ikoerber/roadtest/kicad/roadtest_ref/roadtest.kicad_sch

## KiCad design kicad/roadtest_ref/roadtest.kicad_sch (2026-08-06)

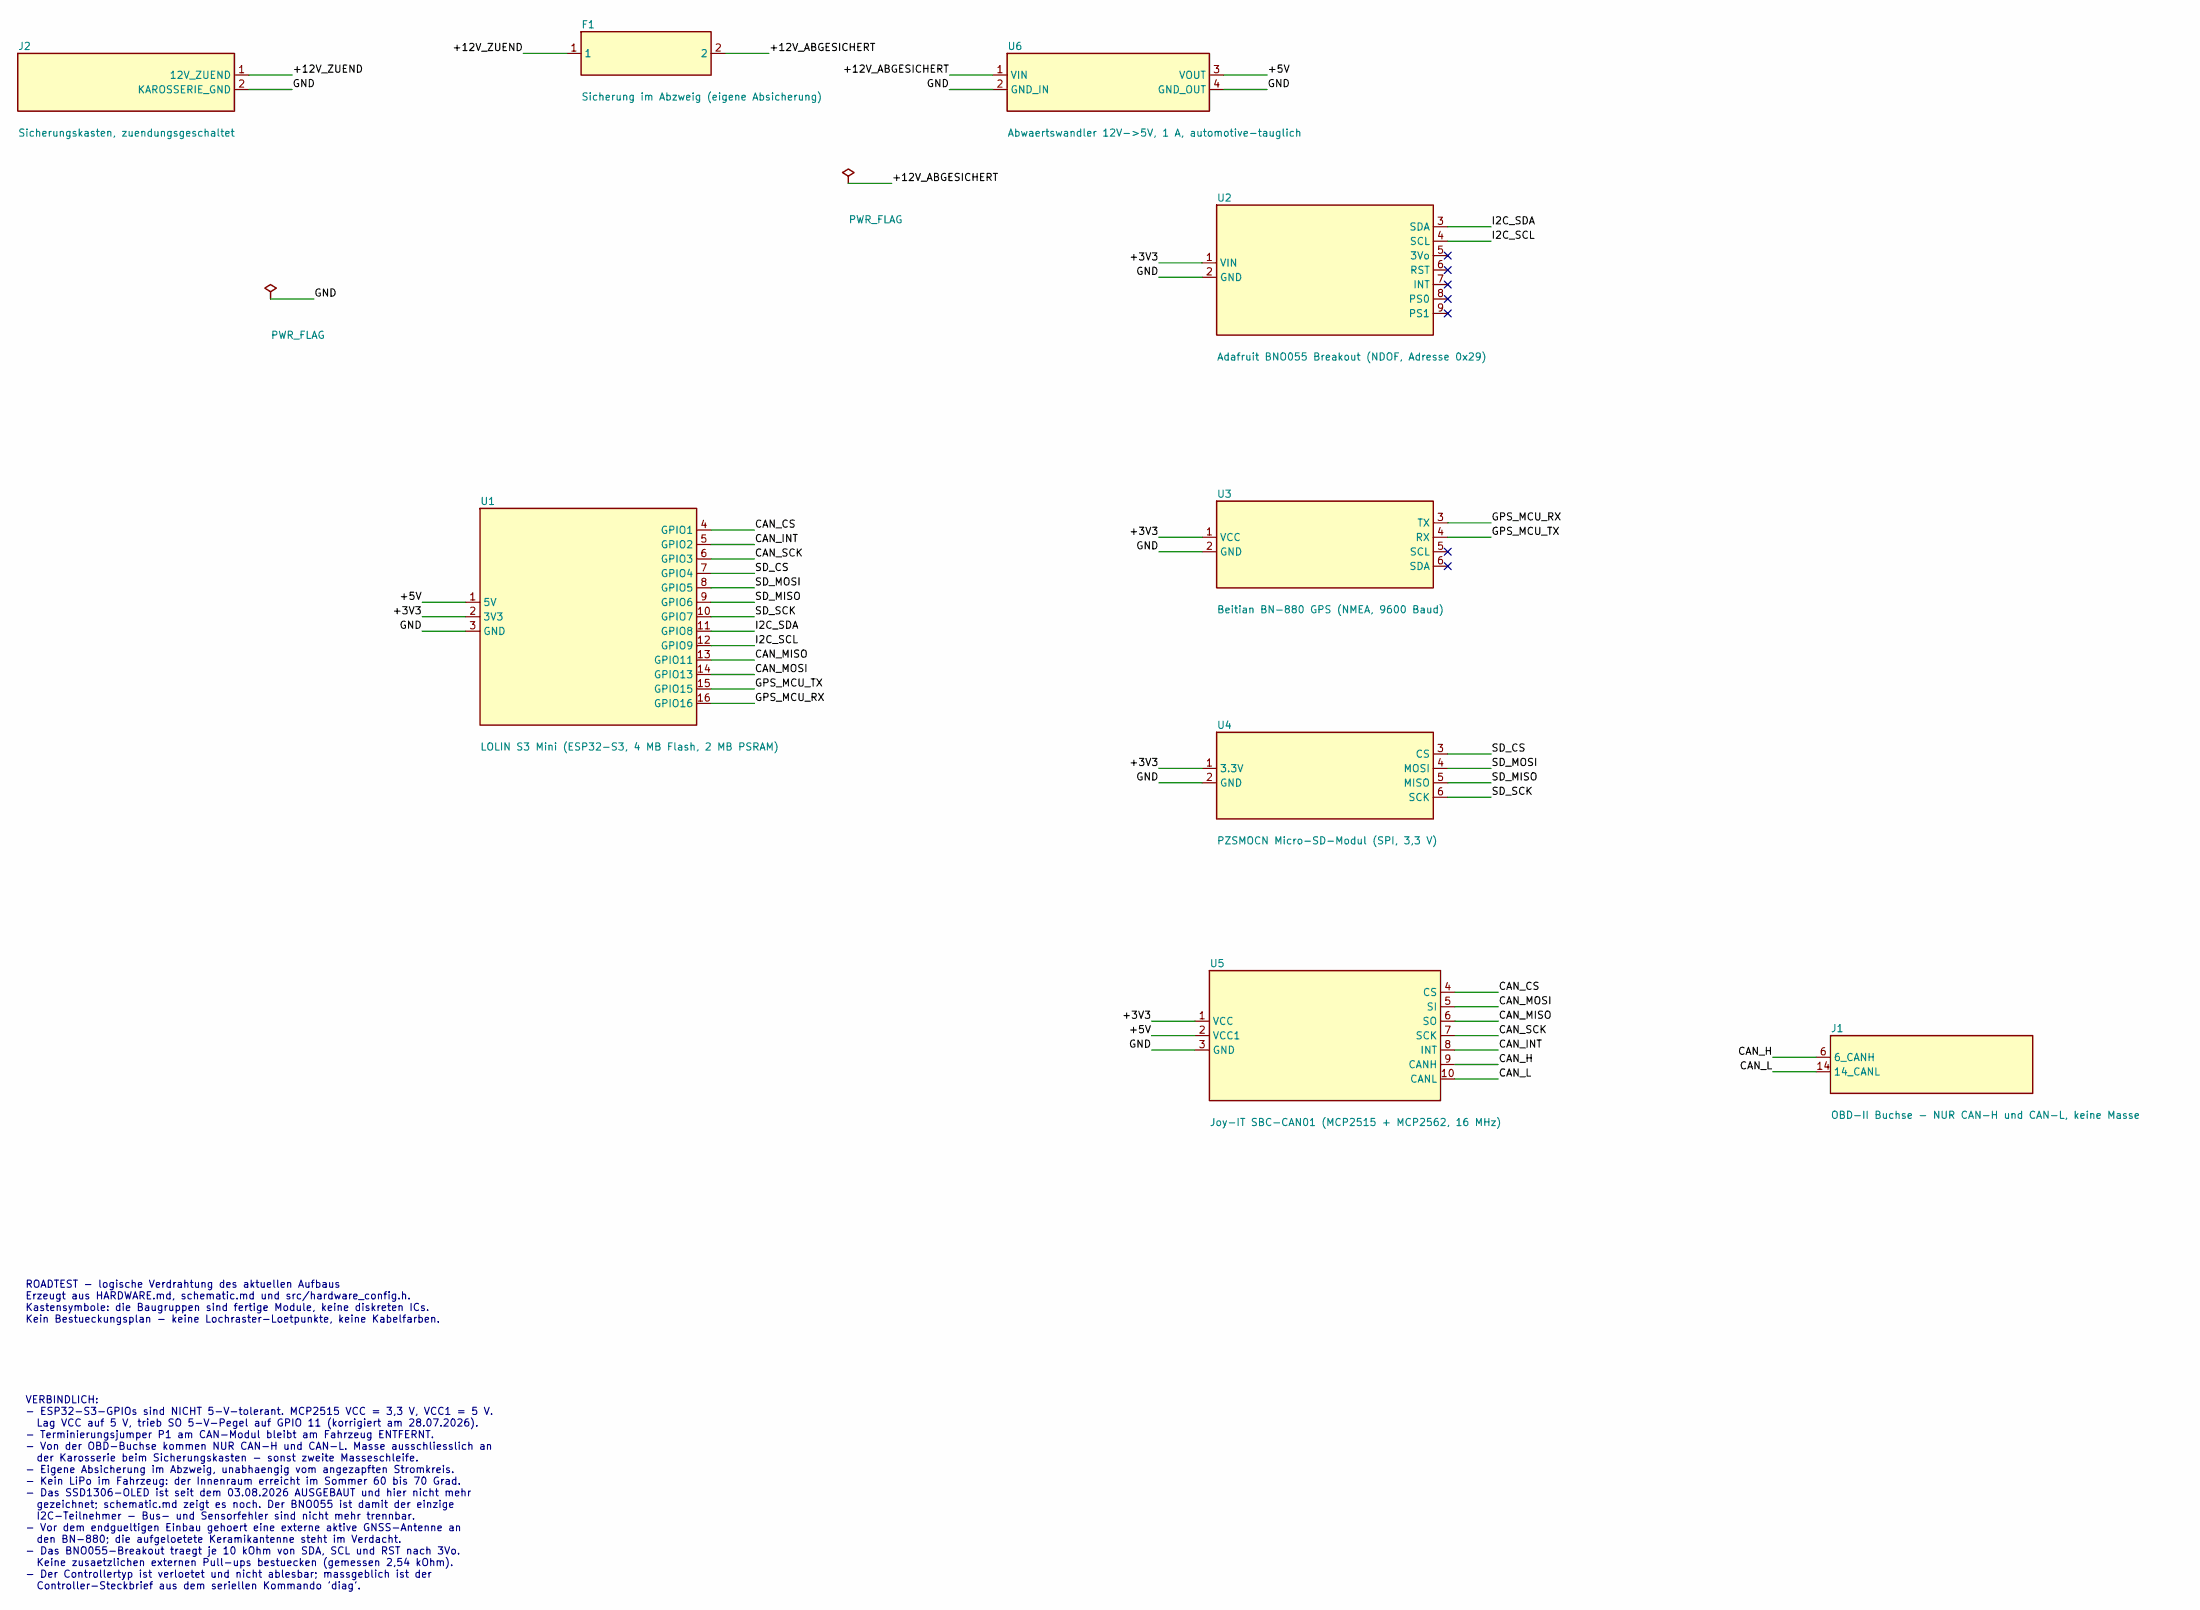
[picture p1: schematic roadtest.kicad_sch]

Parts:
F1: Sicherung im Abzweig (eigene Absicherung)
J1: OBD-II Buchse - NUR CAN-H und CAN-L, keine Masse
J2: Sicherungskasten, zuendungsgeschaltet
U1: LOLIN S3 Mini (ESP32-S3, 4 MB Flash, 2 MB PSRAM)
U2: Adafruit BNO055 Breakout (NDOF, Adresse 0x29)
U3: Beitian BN-880 GPS (NMEA, 9600 Baud)
U4: PZSMOCN Micro-SD-Modul (SPI, 3,3 V)
U5: Joy-IT SBC-CAN01 (MCP2515 + MCP2562, 16 MHz)
U6: Abwaertswandler 12V->5V, 1 A, automotive-tauglich

Connections:
+3V3: U1.2 (3V3), U2.1 (VIN), U3.1 (VCC), U4.1 (3.3V), U5.1 (VCC)
+5V: U1.1 (5V), U5.2 (VCC1), U6.3 (VOUT)
+12V_ABGESICHERT: F1.2, U6.1 (VIN)
+12V_ZUEND: F1.1, J2.1 (12V_ZUEND)
CAN_CS: U1.4 (GPIO1), U5.4 (CS)
CAN_H: J1.6 (6_CANH), U5.9 (CANH)
CAN_INT: U1.5 (GPIO2), U5.8 (INT)
CAN_L: J1.14 (14_CANL), U5.10 (CANL)
CAN_MISO: U1.13 (GPIO11), U5.6 (SO)
CAN_MOSI: U1.14 (GPIO13), U5.5 (SI)
CAN_SCK: U1.6 (GPIO3), U5.7 (SCK)
GND: J2.2 (KAROSSERIE_GND), U1.3 (GND), U2.2 (GND), U3.2 (GND), U4.2 (GND), U5.3 (GND), U6.2 (GND_IN), U6.4 (GND_OUT)
GPS_MCU_RX: U1.16 (GPIO16), U3.3 (TX)
GPS_MCU_TX: U1.15 (GPIO15), U3.4 (RX)
I2C_SCL: U1.12 (GPIO9), U2.4 (SCL)
I2C_SDA: U1.11 (GPIO8), U2.3 (SDA)
SD_CS: U1.7 (GPIO4), U4.3 (CS)
SD_MISO: U1.9 (GPIO6), U4.5 (MISO)
SD_MOSI: U1.8 (GPIO5), U4.4 (MOSI)
SD_SCK: U1.10 (GPIO7), U4.6 (SCK)

Notes on the sheet:
ROADTEST - logische Verdrahtung des aktuellen Aufbaus Erzeugt aus HARDWARE.md, schematic.md und src/hardware_config.h. Kastensymbole: die Baugruppen sind fertige Module, keine diskreten ICs. Kein Bestueckungsplan - keine Lochraster-Loetpunkte, keine Kabelfarben.
VERBINDLICH: - ESP32-S3-GPIOs sind NICHT 5-V-tolerant. MCP2515 VCC = 3,3 V, VCC1 = 5 V. Lag VCC auf 5 V, trieb SO 5-V-Pegel auf GPIO 11 (korrigiert am 28.07.2026). - Terminierungsjumper P1 am CAN-Modul bleibt am Fahrzeug ENTFERNT. - Von der OBD-Buchse kommen NUR CAN-H und CAN-L. Masse ausschliessli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
