ikoerber/roadtest/src/can_reader.cpp

#include "can_reader.h"
#include "hardware_config.h"
#include <SPI.h>

// Include arduino-CAN Library - Wir nutzen MCP2515 auf ESP32
#undef ARDUINO_ARCH_ESP32  // ESP32-internen CAN deaktivieren
#include "CANController.h"
#include "MCP2515.h"

// Globale CAN-Reader Instanz
CANReader canReader;

// MCP2515 Instanz erstellen
MCP2515Class canController;

static_assert(CAN_OBD_REQUEST_INTERVAL_MS >= 500,
              "OBD-Abfragen duerfen insgesamt hoechstens mit 2 Hz laufen");
static_assert(CAN_OBD_RESPONSE_TIMEOUT_MS < CAN_OBD_REQUEST_INTERVAL_MS,
              "OBD-Timeout muss vor der naechsten Anfrage ablaufen");
static_assert(CAN_OBD_VALUE_MAX_AGE_MS >= CAN_OBD_REQUEST_INTERVAL_MS * 3,
              "OBD-Livewerte muessen mindestens einen vollen PID-Zyklus gelten");
static_assert(!CAN_OBD_POLLING_ENABLED || !CAN_LISTEN_ONLY,
              "Aktive OBD-Abfragen sind im Listen-Only-Modus nicht moeglich");

namespace {
// Die Temperatur-PIDs 0x46 und 0x5C rechnen A - 40 über ein einzelnes Byte.
// 0xFF ist dabei die uebliche Kennung "Wert derzeit nicht verfuegbar" und
// ergaebe umgerechnet 215 °C - fuer Aussenluft physikalisch unmoeglich.
//
// Beleg: In den sieben Discovery-Sitzungen vom 29./30.07.2026 trugen 28 von
// rund 530 Antworten auf 0x46 genau dieses Byte. Die Firmware verbuchte sie
// bis 1.5.36 als gueltige Messwerte, in 20260729_170946_05A4DB46 waren das
// 45 von 2438 als gueltig markierten Zeilen. Ein Mittelwert ueber die
// Aussentemperatur lag dadurch mehrere Grad zu hoch.
//
// Die Grenze gilt nur fuer diese beiden PIDs. Bei Geschwindigkeit (0x0D) und
// Drosselstellung (0x11) ist 0xFF ein regulaerer Wert und darf nicht
// verworfen werden.
constexpr uint8_t OBD_TEMPERATURE_UNAVAILABLE = 0xFF;
}  // namespace

CANReader::CANReader(int cs, int interrupt)
    : initialized(false), messageCount(0),
      csPin(cs), intPin(interrupt),
      clockFrequency(CAN_CLOCK_16MHZ),
      totalMessages(0), errorCount(0),
      receiveBuffer0OverflowCount(0),
      receiveBuffer1OverflowCount(0),
      controllerRecoveryCount(0),
      lastMessage{}, pendingMessage{}, hasPendingMessage(false), obdData{},
      obdPollingEnabled(CAN_OBD_POLLING_ENABLED), obdSession{},
      obdRequestPending(false), pendingOBDHadResponse(false),
      pendingOBDSequence(0),
      pendingOBDRequestMs(0), pendingOBDPid(0), obdTraceQueue{},
      obdTraceReadIndex(0), obdTraceWriteIndex(0) {
}

CANReader::~CANReader() {
    end();
}

bool CANReader::begin(long baudRate) {
    if (initialized) {
        Serial.println("CAN-Reader bereits initialisiert");
        return true;
    }
    
    Serial.println("=== CAN-Bus Reader Initialisierung ===");
    Serial.printf("Pins: CS=%d, INT=%d, SCK=%d, MOSI=%d, MISO=%d\n",
                  csPin, intPin, CAN_SCK_PIN, CAN_MOSI_PIN, CAN_MISO_PIN);

    // Der SPI-Bus wird vom Aufrufer einmalig eingerichtet, siehe
    // initializeOptionalCAN() in main.cpp.
    //
    // Frühere Fassungen riefen hier erneut SPI.end() und SPI.begin() auf, mit
    // dem Kommentar, damit werde "eventuelle SD-SPI Nutzung" beendet. Das war
    // sachlich falsch: Die SD-Karte hängt an der eigenen HSPI-Instanz, CAN am
    // globalen SPI-Objekt. Es sind getrennte Peripherien. Ein Busneustart zur
    // Laufzeit bringt hier nichts und kann eine laufende Übertragung abreißen.
    //
    // Ebenfalls entfernt: die Toggle-Tests, die SCK und MOSI per pinMode() und
    // digitalWrite() ansteuerten, nachdem SPI.begin() dieselben Pins bereits
    // über die GPIO-Matrix der SPI-Einheit zugewiesen hatte. Beide Treiber
    // arbeiteten dabei gegeneinander.
    pinMode(intPin, INPUT_PULLUP);
    pinMode(csPin, OUTPUT);
    digitalWrite(csPin, HIGH);

    canController.setPins(csPin, intPin);

    // MCP2515 mit der fest hinterlegten Quarzfrequenz konfigurieren.
    // Der verbaute Joy-IT SBC-CAN01 trägt einen Quarz mit Aufdruck 16.000.
    // Früher wurde hier 16 MHz probiert und bei Misserfolg auf 8 MHz
    // umgeschaltet. Das ist gefährlich: Eine falsche Annahme wird von
    // begin() nicht erkannt, sondern ergibt eine um Faktor zwei falsche
    // Bitrate. Der Knoten quittiert dann jeden Frame als Fehler, geht in
    // Bus-Off und hält die INT-Leitung dauerhaft aktiv.
    Serial.printf("MCP2515: Quarz %ld Hz, Bitrate %ld bps\n",
                  clockFrequency, baudRate);
    canController.setClockFrequency(clockFrequency);
    canController.setSPIFrequency(1E6); // Niedrige SPI-Geschwindigkeit
    canController.setListenOnly(CAN_LISTEN_ONLY);
    canController.setTransmitTimeout(CAN_TX_TIMEOUT_MS);
    Serial.printf("MCP2515-Modus: %s\n",
                  CAN_OBD_POLLING_ENABLED
                      ? "OBD-Abfrage (aktiv, nur lesend)"
                      : (CAN_LISTEN_ONLY ? "Listen-Only (passiv)" : "Normal"));

    if (!canController.begin(baudRate)) {
        Serial.println("❌ CAN-Bus Initialisierung fehlgeschlagen!");
        Serial.println("Mögliche Ursachen:");
        Serial.printf("• Verkabelung: CS=GPIO%d, INT=GPIO%d, SCK=GPIO%d, MOSI=GPIO%d, MISO=GPIO%d\n",
                      csPin, intPin, CAN_SCK_PIN, CAN_MOSI_PIN, CAN_MISO_PIN);
        Serial.println("• Stromversorgung: VCC=3,3V (Logik), VCC1=5V (Bustreiber)");
        Serial.println("• Quarzaufdruck gegen CAN_CLOCK_16MHZ in hardware_config.h prüfen");
        Serial.println("• MCP2515 defekt oder nicht verbunden");
        errorCount++;
        return false;
    }

    // Im aktiven OBD-Modus nur die acht standardisierten physischen
    // Antwort-IDs in die beiden MCP2515-Empfangspuffer lassen. So verdrängt
    // normaler Fahrzeugverkehr keine angeforderte OBD-Antwort.
    if (CAN_OBD_POLLING_ENABLED &&
        !canController.filter(0x7E8, 0x7F8)) {
        Serial.println("❌ OBD-Antwortfilter konnte nicht gesetzt werden");
        canController.end();
        errorCount++;
        return false;
    }
    
    initialized = true;
    hasPendingMessage = false;
    pendingMessage = CANMessage{};
    // Boot- und Sitzungszähler gehören dem CANReader, nicht einer einzelnen
    // Controller-Initialisierung. Nach einem fehlgeschlagenen Recovery-Versuch
    // darf der spätere erfolgreiche begin()-Pfad deshalb weder OBD-Trace noch
    // Überlauf-, Nachrichten- oder Recovery-Zähler zurücksetzen.
    
    Serial.println("✅ CAN-Bus Reader erfolgreich gestartet!");
    Serial.printf("Bereit für Nachrichten auf %ld bps\n", baudRate);
    if (CAN_OBD_POLLING_ENABLED) {
        Serial.printf("OBD-II Service 01: PID 0C/0D/11, Intervall %d ms\n",
                      CAN_OBD_REQUEST_INTERVAL_MS);
    }
    
    return true;
}

bool CANReader::restartController(long baudRate, bool passiveMode) {
    if (obdSession.active && obdRequestPending) {
        finishPendingOBDTimeout(millis());
    }

    hasPendingMessage = false;
    pendingMessage = CANMessage{};
    initialized = false;
    canController.end();

    SPI.begin(CAN_SCK_PIN, CAN_MISO_PIN, CAN_MOSI_PIN);
    SPI.setFrequency(1000000);
    SPI.setDataMode(SPI_MODE0);
    SPI.setBitOrder(MSBFIRST);
    pinMode(intPin, INPUT_PULLUP);
    pinMode(csPin, OUTPUT);
    digitalWrite(csPin, HIGH);

    canController.setPins(csPin, intPin);
    canController.setClockFrequency(clockFrequency);
    canController.setSPIFrequency(1E6);
    canController.setListenOnly(passiveMode);
    canController.setTransmitTimeout(CAN_TX_TIMEOUT_MS);

    if (!canController.begin(baudRate)) {
        errorCount++;
        Serial.println("❌ MCP2515-Recovery: Initialisierung fehlgeschlagen");
        return false;
    }

    const bool filterConfigured =
        passiveMode
            ? canController.filter(0x000, 0x000)
            : canController.filter(0x7E8, 0x7F8);
    if (!filterConfigured) {
        canController.end();
        errorCount++;
        Serial.println("❌ MCP2515-Recovery: Filter konnte nicht gesetzt werden");
        return false;
    }

    initialized = true;
    controllerRecoveryCount++;
    Serial.printf(
        "✅ MCP2515-Recovery #%lu: %s\n",
        static_cast<unsigned long>(controllerRecoveryCount),
        passiveMode ? "Listen-Only" : "OBD-Antwortbetrieb");
    return true;
}

void CANReader::end() {
    if (!initialized) return;

    canController.end();
    initialized = false;
    hasPendingMessage = false;
    pendingMessage = CANMessage{};
    obdRequestPending = false;
    pendingOBDHadResponse = false;

    Serial.println("CAN-Bus Reader beendet");
}

void CANReader::setPins(int cs, int interrupt) {
    if (initialized) {
        Serial.println("Warnung: Pin-Änderung nur vor begin() möglich");
        return;
    }
    
    csPin = cs;
    intPin = interrupt;
}

void CANReader::setClockFrequency(long clockFreq) {
    if (initialized) {
        Serial.println("Warnung: Clock-Frequenz nur vor begin() änderbar");
        return;
    }

    // Nur merken. Angewendet wird der Wert in begin(), sonst würde ihn die
    // dortige Konfiguration wieder überschreiben.
    clockFrequency = clockFreq;
}

bool CANReader::fetchPacket() {
    if (hasPendingMessage) {
        return true;
    }
    if (!initialized) {
        return false;
    }

    // parsePacket() liest den Frame aus dem Empfangspuffer des MCP2515 und
    // quittiert dabei RXnIF. Ein zweiter Aufruf findet die Nachricht deshalb
    // nicht mehr vor. Genau das passierte bisher: hasMessage() parste den
    // Frame, readMessage() rief parsePacket() erneut auf, bekam nichts mehr
    // und lieferte eine leere Nachricht zurück - jeder Frame ging verloren.
    // Das Ergebnis wird deshalb hier zwischengespeichert.
    const int packetSize = canController.parsePacket();
    if (packetSize <= 0 && canController.packetId() == -1) {
        return false;
    }

    pendingMessage = CANMessage{};
    pendingMessage.timestamp = millis();
    pendingMessage.canId = canController.packetId();
    pendingMessage.extended = canController.packetExtended();
    pendingMessage.rtr = canController.packetRtr();
    pendingMessage.dlc = canController.packetDlc();
    pendingMessage.rssi = 0.0f; // Nicht verfügbar bei MCP2515

    int dataIndex = 0;
    while (canController.available() && dataIndex < 8) {
        pendingMessage.data[dataIndex++] = canController.read();
    }

    hasPendingMessage = true;
    messageCount++;
    totalMessages++;

    return true;
}

bool CANReader::hasMessage() {
    return fetchPacket();
}

CANMessage CANReader::readMessage() {
    if (!fetchPacket()) {
        // Keine Nachricht vorhanden. Der Aufrufer sollte vorher hasMessage()
        // prüfen; die CAN-ID 0x000 ist ein gültiger Bezeichner und taugt
        // deshalb nicht als Kennzeichen für "leer".
        return CANMessage{};
    }

    hasPendingMessage = false;
    lastMessage = pendingMessage;
    return pendingMessage;
}

void CANReader::enqueueOBDTrace(const OBDTraceEvent& event) {
    const uint8_t nextIndex =
        (obdTraceWriteIndex + 1) % OBD_TRACE_QUEUE_SIZE;
    if (nextIndex == obdTraceReadIndex) {
        obdSession.traceDropped++;
        return;
    }

    obdTraceQueue[obdTraceWriteIndex] = event;
    obdTraceWriteIndex = nextIndex;
}

bool CANReader::popOBDTraceEvent(OBDTraceEvent& event) {
    if (obdTraceReadIndex == obdTraceWriteIndex) {
        return false;
    }

    event = obdTraceQueue[obdTraceReadIndex];
    obdTraceReadIndex =
        (obdTraceReadIndex + 1) % OBD_TRACE_QUEUE_SIZE;
    return true;
}

void CANReader::finishPendingOBDTimeout(uint32_t now) {
    if (!obdSession.active || !obdRequestPending) {
        return;
    }

    // Eine funktionale Anfrage kann Antworten mehrerer Steuergeräte
    // auslösen. Das Fenster bleibt deshalb bis zum Timeout offen; sobald
    // mindestens eine passende Antwort kam, wird es ohne Timeout-Zähler
    // abgeschlossen.
    if (pendingOBDHadResponse) {
        obdRequestPending = false;
        pendingOBDHadResponse = false;
        return;
    }

    OBDTraceEvent event;
    event.type = OBDTraceEventType::TIMEOUT;
    event.sequence = pendingOBDSequence;
    event.eventUptimeMs = now;
    event.requestUptimeMs = pendingOBDRequestMs;
    event.pid = pendingOBDPid;
    event.transmitOK = true;
    event.matchedRequest = true;
    enqueueOBDTrace(event);

    obdSession.timeoutCount++;
    obdRequestPending = false;
    pendingOBDHadResponse = false;
}

void CANReader::updateOBDDiagnostics() {
    if (!obdSession.active || !obdRequestPending) {
        return;
    }

    const uint32_t now = millis();
    if (now - pendingOBDRequestMs >= CAN_OBD_RESPONSE_TIMEOUT_MS) {
        finishPendingOBDTimeout(now);
    }
}

void CANReader::beginOBDSession() {
    const uint32_t bootRequests = obdData.requestCount;
    const uint32_t bootResponses = obdData.responseCount;
    const uint32_t bootRequestErrors = obdData.requestErrors;
    obdData = OBDLiveData{};
    obdData.requestCount = bootRequests;
    obdData.responseCount = bootResponses;
    obdData.requestErrors = bootRequestErrors;

    obdSession = OBDSessionStats{};
    obdSession.active = true;
    obdSession.startedAt = millis();
    obdRequestPending = false;
    pendingOBDHadResponse = false;
    pendingOBDSequence = 0;
    pendingOBDRequestMs = 0;
    pendingOBDPid = 0;
    obdTraceReadIndex = 0;
    obdTraceWriteIndex = 0;
}

void CANReader::endOBDSession() {
    updateOBDDiagnostics();
    obdRequestPending = false;
    pendingOBDHadResponse = false;
    obdSession.active = false;
}

bool CANReader::requestOBDPid(uint8_t pid) {
    if (!initialized || !CAN_OBD_POLLING_ENABLED || !obdPollingEnabled) {
        return false;
    }

    // Bewusst feste Positivliste: Neben den bisher verwendeten Livewerten
    // sind nur die vier standardisierten Unterstützungsblöcke sowie die für
    // die Datenerkennung benötigten, ausschließlich lesenden PIDs zulässig.
    const bool allowed =
        pid == 0x00 || pid == 0x20 || pid == 0x40 || pid == 0x60 ||
        pid == 0x0C || pid == 0x0D || pid == 0x10 || pid == 0x11 ||
        pid == 0x46 || pid == 0x5C || pid == 0x5E;
    if (!allowed) {
        return false;
    }

    // Funktionale ISO-15765-4-Anfrage an alle OBD-Steuergeräte:
    // Single Frame, zwei Nutzbytes, Service 01 (aktuelle Messwerte).
    const uint8_t request[8] = {0x02, 0x01, pid, 0x00, 0x00, 0x00, 0x00, 0x00};
    updateOBDDiagnostics();
    const uint32_t requestMs = millis();
    obdData.requestCount++;
    if (obdSession.active) {
        obdSession.requestCount++;
        obdSession.lastRequestSequence = obdSession.requestCount;
        obdSession.lastRequestMs = requestMs;
        obdSession.lastRequestPid = pid;
    }

    const bool transmitOK =
        canController.beginPacket(0x7DF, 8) &&
        canController.write(request, sizeof(request)) == sizeof(request) &&
        canController.endPacket();

    if (obdSession.active) {
        OBDTraceEvent event;
        event.type = transmitOK
            ? OBDTraceEventType::REQUEST_SENT
            : OBDTraceEventType::TRANSMIT_ERROR;
        event.sequence = obdSession.lastRequestSequence;
        event.eventUptimeMs = millis();
        event.requestUptimeMs = requestMs;
        event.pid = pid;
        event.transmitOK = transmitOK;
        enqueueOBDTrace(event);
        obdSession.lastTransmitOK = transmitOK;
    }

    if (!transmitOK) {
        obdData.requestErrors++;
        if (obdSession.active) {
            obdSession.requestErrors++;
        }
        errorCount++;
        return false;
    }

    if (obdSession.active) {
        obdRequestPending = true;
        pendingOBDHadResponse = false;
        pendingOBDSequence = obdSession.lastRequestSequence;
        pendingOBDRequestMs = requestMs;
        pendingOBDPid = pid;
    }

    return true;
}

bool CANReader::processOBDResponse(const CANMessage& msg) {
    if (msg.extended || msg.rtr || msg.canId < 0x7E8 ||
        msg.canId > 0x7EF || msg.dlc < 4) {
        return false;
    }

    // Nur ISO-TP Single Frames und positive Antworten auf Service 01
    // akzeptieren. Diagnose-, Schreib- oder Steuerdienste werden nicht
    // implementiert.
    const uint8_t payloadLength = msg.data[0] & 0x0F;
    if ((msg.data[0] & 0xF0) != 0x00 || payloadLength < 3 ||
        payloadLength + 1 > msg.dlc ||
        msg.data[1] != 0x41) {
        return false;
    }

    const uint8_t pid = msg.data[2];
    const unsigned long now = millis();
    bool decoded = false;

    // 00/20/40/60 liefern je eine 32-Bit-Bitmap für die darauf folgenden
    // PIDs. Antworten mehrerer Steuergeräte werden als Vereinigungsmenge
    // gespeichert; die Rohframes mit ihrer jeweiligen ECU-ID bleiben
    // zusätzlich vollständig im CAN-Log erhalten.
    if ((pid == 0x00 || pid == 0x20 || pid == 0x40 || pid == 0x60) &&
        payloadLength >= 6 && msg.dlc >= 7) {
        const uint8_t block = pid / 0x20;
        const uint32_t bitmap =
            (static_cast<uint32_t>(msg.data[3]) << 24) |
            (static_cast<uint32_t>(msg.data[4]) << 16) |
            (static_cast<uint32_t>(msg.data[5]) << 8) |
            static_cast<uint32_t>(msg.data[6]);
        obdData.supportBlockValid[block] = true;
        obdData.supportBitmap[block] |= bitmap;
        obdData.supportResponseCount++;
        decoded = true;
    } else if (pid == 0x0C && payloadLength >= 4 && msg.dlc >= 5) {
        obdData.rpm =
            ((static_cast<uint16_t>(msg.data[3]) << 8) | msg.data[4]) / 4.0f;
        obdData.rpmValid = true;
        obdData.rpmUpdatedMs = now;
        decoded = true;
    } else if (pid == 0x0D) {
        obdData.speedKmh = msg.data[3];
        obdData.speedValid = true;
        obdData.speedUpdatedMs = now;
        decoded = true;
    } else if (pid == 0x10 && payloadLength >= 4 && msg.dlc >= 5) {
        obdData.mafGramsPerSecond =
            ((static_cast<uint16_t>(msg.data[3]) << 8) | msg.data[4]) /
            100.0f;
        obdData.mafValid = true;
        obdData.mafUpdatedMs = now;
        decoded = true;
    } else if (pid == 0x11) {
        obdData.throttlePercent = msg.data[3] * 100.0f / 255.0f;
        obdData.throttleValid = true;
        obdData.throttleUpdatedMs = now;
        decoded = true;
    } else if (pid == 0x46) {
        // Die Antwort zählt auch ohne Messwert als Antwort: decoded bleibt
        // true, damit ECU-Erreichbarkeit und Timeoutbuchführung stimmen. Nur
        // das Gültigkeitsflag bleibt aus, und ohne frischen Zeitstempel
        // altert ein zuvor gemessener Wert über die bestehende Altersgrenze
        // regulär aus.
        if (msg.data[3] != OBD_TEMPERATURE_UNAVAILABLE) {
            obdData.ambientTemperatureC =
                static_cast<int16_t>(msg.data[3]) - 40.0f;
            obdData.ambientTemperatureValid = true;
            obdData.ambientTemperatureUpdatedMs = now;
        }
        decoded = true;
    } else if (pid == 0x5C) {
        if (msg.data[3] != OBD_TEMPERATURE_UNAVAILABLE) {
            obdData.oilTemperatureC =
                static_cast<int16_t>(msg.data[3]) - 40.0f;
            obdData.oilTemperatureValid = true;
            obdData.oilTemperatureUpdatedMs = now;
        }
        decoded = true;
    } else if (pid == 0x5E && payloadLength >= 4 && msg.dlc >= 5) {
        obdData.fuelRateLitersPerHour =
            ((static_cast<uint16_t>(msg.data[3]) << 8) | msg.data[4]) *
            0.05f;
        obdData.fuelRateValid = true;
        obdData.fuelRateUpdatedMs = now;
        decoded = true;
    }

    if (decoded) {
        obdData.lastResponseMs = now;
        obdData.lastPid = pid;
        obdData.responseCount++;

        if (obdSession.active) {
            const bool matched =
                obdRequestPending && pendingOBDPid == pid;
            const uint32_t sequence =
                matched ? pendingOBDSequence : 0;
            const uint32_t requestMs =
                matched ? pendingOBDRequestMs : 0;
            const uint32_t latency =
                matched ? now - pendingOBDRequestMs : 0;

            obdSession.responseCount++;
            if (pid == 0x00 || pid == 0x20 ||
                pid == 0x40 || pid == 0x60) {
                obdSession.supportResponseCount++;
            }
            if (!matched) {
                obdSession.unmatchedResponseCount++;
            }
            obdSession.lastResponseMs = now;
            obdSession.lastResponseLatencyMs = latency;
            obdSession.lastResponseCanId =
                static_cast<uint32_t>(msg.canId);
            obdSession.lastResponsePid = pid;

            OBDTraceEvent event;
            event.type = OBDTraceEventType::RESPONSE;
            event.sequence = sequence;
            event.eventUptimeMs = now;
            event.requestUptimeMs = requestMs;
            event.responseUptimeMs = now;
            event.responseLatencyMs = latency;
            event.responseCanId =
                static_cast<uint32_t>(msg.canId);
            event.pid = pid;
            event.transmitOK = matched;
            event.matchedRequest = matched;
            enqueueOBDTrace(event);

            if (matched) {
                pendingOBDHadResponse = true;
            }
        }
    }
    return decoded;
}

OBDLiveData CANReader::getOBDData() const {
    OBDLiveData current = obdData;
    const unsigned long now = millis();
    if (current.rpmValid &&
        now - current.rpmUpdatedMs > CAN_OBD_VALUE_MAX_AGE_MS) {
        current.rpmValid = false;
    }
    if (current.speedValid &&
        now - current.speedUpdatedMs > CAN_OBD_VALUE_MAX_AGE_MS) {
        current.speedValid = false;
    }
    if (current.throttleValid &&
        now - current.throttleUpdatedMs > CAN_OBD_VALUE_MAX_AGE_MS) {
        current.throttleValid = false;
    }
    if (current.mafValid &&
        now - current.mafUpdatedMs > CAN_OBD_SLOW_VALUE_MAX_AGE_MS) {
        current.mafValid = false;
    }
    if (current.ambientTemperatureValid &&
        now - current.ambientTemperatureUpdatedMs >
            CAN_OBD_SLOW_VALUE_MAX_AGE_MS) {
        current.ambientTemperatureValid = false;
    }
    if (current.oilTemperatureValid &&
        now - current.oilTemperatureUpdatedMs >
            CAN_OBD_SLOW_VALUE_MAX_AGE_MS) {
        current.oilTemperatureValid = false;
    }
    if (current.fuelRateValid &&
        now - current.fuelRateUpdatedMs > CAN_OBD_SLOW_VALUE_MAX_AGE_MS) {
        current.fuelRateValid = false;
    }
    return current;
}

void CANReader::resetOBDDiscoveryData() {
    obdData.supportResponseCount = 0;
    for (uint8_t block = 0; block < 4; block++) {
        obdData.supportBlockValid[block] = false;
        obdData.supportBitmap[block] = 0;
    }
}

const char* obdTraceEventName(OBDTraceEventType type) {
    switch (type) {
        case OBDTraceEventType::REQUEST_SENT:
            return "REQUEST_SENT";
        case OBDTraceEventType::TRANSMIT_ERROR:
            return "TRANSMIT_ERROR";
        case OBDTraceEventType::RESPONSE:
            return "RESPONSE";
        case OBDTraceEventType::TIMEOUT:
            return "TIMEOUT";
    }
    return "UNKNOWN";
}

bool CANReader::isOBDPidSupportKnown(uint8_t pid) const {
    if (pid == 0 || pid > 0x80) {
        return false;
    }
    const uint8_t block = (pid - 1) / 0x20;
    return block < 4 && obdData.supportBlockValid[block];
}

bool CANReader::isOBDPidSupported(uint8_t pid) const {
    if (!isOBDPidSupportKnown(pid)) {
        return false;
    }
    const uint8_t block = (pid - 1) / 0x20;
    const uint8_t offset = pid - block * 0x20;
    return (obdData.supportBitmap[block] &
            (static_cast<uint32_t>(1) << (32 - offset))) != 0;
}

bool CANReader::configurePassiveCapture() {
    if (!initialized) {
        return false;
    }

    // Bereits gepufferte OBD-Antworten gehören nicht in die passive Phase.
    hasPendingMessage = false;
    pendingMessage = CANMessage{};
    for (uint8_t buffer = 0; buffer < 2; buffer++) {
        const int packetSize = canController.parsePacket();
        if (packetSize <= 0 && canController.packetId() == -1) {
            break;
        }
        while (canController.available()) {
            canController.read();
        }
    }

    canController.setListenOnly(true);
    if (!canController.filter(0x000, 0x000)) {
        Serial.println("❌ CAN konnte nicht auf passiven Empfang umgeschaltet werden");
        errorCount++;
        return false;
    }

    Serial.println("✅ CAN: Listen-Only aktiv, alle 11-Bit-IDs freigegeben");
    return true;
}

bool CANReader::configureOBDResponseMode() {
    if (!initialized) {
        return false;
    }

    hasPendingMessage = false;
    pendingMessage = CANMessage{};
    for (uint8_t buffer = 0; buffer < 2; buffer++) {
        const int packetSize = canController.parsePacket();
        if (packetSize <= 0 && canController.packetId() == -1) {
            break;
        }
        while (canController.available()) {
            canController.read();
        }
    }

    canController.setListenOnly(false);
    if (!canController.filter(0x7E8, 0x7F8)) {
        Serial.println("❌ CAN konnte nicht auf OBD-Antwortbetrieb umgeschaltet werden");
        errorCount++;
        return false;
    }

    Serial.println("✅ CAN: OBD-Antwortbetrieb, Filter 0x7E8..0x7EF");
    return true;
}

int CANReader::getAvailableMessages() {
    // Der MCP2515 gibt keine Anzahl wartender Frames heraus; available() des
    // Treibers meldet lediglich die Restbytes des gerade geparsten Frames.
    // Hier zählt deshalb nur, ob ein abholbereiter Frame vorliegt.
    return fetchPacket() ? 1 : 0;
}

void CANReader::setFilter(long id, long mask) {
    if (!initialized) {
        Serial.println("CAN-Reader nicht initialisiert für Filter");
        return;
    }
    
    if (canController.filter(id, mask)) {
        Serial.printf("✅ Standard-Filter gesetzt: ID=0x%lX, Mask=0x%lX\n", id, mask);
    } else {
        Serial.printf("❌ Filter-Fehler: ID=0x%lX, Mask=0x%lX\n", id, mask);
        errorCount++;
    }
}

void CANReader::setExtendedFilter(long id, long mask) {
    if (!initialized) {
        Serial.println("CAN-Reader nicht initialisiert für Extended-Filter");
        return;
    }
    
    if (canController.filterExtended(id, mask)) {
        Serial.printf("✅ Extended-Filter gesetzt: ID=0x%lX, Mask=0x%lX\n", id, mask);
    } else {
        Serial.printf("❌ Extended-Filter-Fehler: ID=0x%lX, Mask=0x%lX\n", id, mask);
        errorCount++;
    }
}

void CANReader::clearFilters() {
    // Alle Nachrichten empfangen (Standard-Verhalten)
    setFilter(0x000, 0x000);
}

void CANReader::dumpRegisters() {
    if (!initialized) {
        Serial.println("CAN-Reader nicht initialisiert für Register-Dump");
        return;
    }
    
    Serial.println("=== MCP2515 Register-Dump ===");
    canController.dumpRegisters(Serial);
}

CANHardwareDiagnostics CANReader::getHardwareDiagnostics() {
    CANHardwareDiagnostics result;
    if (!initialized) {
        return result;
    }

    const MCP2515Diagnostics raw = canController.readDiagnostics();
    result.valid = true;
    result.operatingMode = (raw.canStatus >> 5) & 0x07;
    result.transmitErrorCount = raw.transmitErrorCount;
    result.receiveErrorCount = raw.receiveErrorCount;
    result.errorFlags = raw.errorFlags;
    result.txBuffer0Control = raw.txBuffer0Control;
    result.errorWarning = raw.errorFlags & 0x01;
    result.receiveWarning = raw.errorFlags & 0x02;
    result.transmitWarning = raw.errorFlags & 0x04;
    result.receiveErrorPassive = raw.errorFlags & 0x08;
    result.transmitErrorPassive = raw.errorFlags & 0x10;
    result.transmitBusOff = raw.errorFlags & 0x20;
    result.receiveBuffer0Overflow = raw.errorFlags & 0x40;
    result.receiveBuffer1Overflow = raw.errorFlags & 0x80;
    if (result.receiveBuffer0Overflow) {
        receiveBuffer0OverflowCount++;
    }
    if (result.receiveBuffer1Overflow) {
        receiveBuffer1OverflowCount++;
    }
    if (result.receiveBuffer0Overflow ||
        result.receiveBuffer1Overflow) {
        canController.clearReceiveOverflowFlags();
    }
    result.receiveBuffer0OverflowCount =
        receiveBuffer0OverflowCount;
    result.receiveBuffer1OverflowCount =
        receiveBuffer1OverflowCount;
    result.controllerRecoveryCount =
        controllerRecoveryCount;
    return result;
}

String CANReader::getStatusString() {
    static char statusBuffer[512];
    
    int written = snprintf(statusBuffer, sizeof(statusBuffer),
        "CAN-Reader Status:\n"
        "  Initialisiert: %s\n"
        "  Nachrichten empfangen: %lu\n"
        "  Gesamt-Nachrichten: %lu\n"
        "  Fehler: %lu\n",
        initialized ? "Ja" : "Nein",
        (unsigned long)messageCount,
        (unsigned long)totalMessages,
        (unsigned long)errorCount
    );
    (void)written;

    return String(statusBuffer);
}

void CANReader::onReceive(void(*callback)(int)) {
    // Bewusst nicht an den Treiber weitergereicht.
    //
    // MCP2515Class::onReceive() haengt den Callback an einen GPIO-Interrupt.
    // Der Handler ruft handleInterrupt() und darueber parsePacket() und
    // readRegister() auf - also SPI-Transfers. SPI.beginTransaction() nimmt
    // auf dem ESP32 einen FreeRTOS-Mutex; das im Interruptkontext zu tun
    // fuehrt zum Abbruch der Firmware. Zusaetzlich liegt der Handler nicht im
    // IRAM.
    //
    // Der unterstuetzte Weg ist das Polling in loop(): dort wird alle 10 ms
    // hasMessage() geprueft und readMessage() abgeholt.
    (void)callback;
    Serial.println("⚠️ CAN-Callback nicht unterstuetzt: Der Treiber wuerde SPI "
                   "im Interruptkontext ausfuehren.");
    Serial.println("   Nachrichten werden stattdessen in loop() abgefragt.");
}

// Hilfsfunktionen
String formatCANMessage(const CANMessage& msg) {
    static char msgBuffer[256];
    char* ptr = msgBuffer;
    size_t remaining = sizeof(msgBuffer);
    
    // Time und ID
    int written = snprintf(ptr, remaining, "Time: %lums, ID: %s, ", 
                          msg.timestamp, getCANIdString(msg.canId, msg.extended).c_str());
    if (written > 0 && written < (int)remaining) {
        ptr += written;
        remaining -= written;
    }
    
    // Flags
    if (msg.extended && remaining > 5) {
        strncpy(ptr, "EXT, ", remaining);
        ptr += 5;
        remaining -= 5;
    }
    if (msg.rtr && remaining > 5) {
        strncpy(ptr, "RTR, ", remaining);
        ptr += 5;
        remaining -= 5;
    }
    
    // DLC
    written = snprintf(ptr, remaining, "DLC: %d", msg.dlc);
    if (written > 0 && written < (int)remaining) {
        ptr += written;
        remaining -= written;
    }
    
    // Data bytes
    if (!msg.rtr && msg.dlc > 0 && remaining > 10) {
        strncpy(ptr, ", Data: ", remaining);
        ptr += 8;
        remaining -= 8;
        
        for (int i = 0; i < msg.dlc && remaining > 3; i++) {
            written = snprintf(ptr, remaining, "%02X", msg.data[i]);
            if (written > 0 && written < (int)remaining) {
                ptr += written;
                remaining -= written;
                
                if (i < msg.dlc - 1 && remaining > 1) {
                    *ptr++ = ' ';
                    remaining--;
                }
            }
        }
    }
    
    *ptr = '\0';
    return String(msgBuffer);
}

String getCANIdString(long id, bool extended) {
    static char idBuffer[32];
    
    if (extended) {
        snprintf(idBuffer, sizeof(idBuffer), "0x%lX (29-bit)", id);
    } else {
        snprintf(idBuffer, sizeof(idBuffer), "0x%lX (11-bit)", id);
    }
    
    return String(idBuffer);
}

void printCANMessage(const CANMessage& msg) {
    Serial.println("--- CAN-Nachricht ---");
    Serial.println(formatCANMessage(msg));
    
    if (!msg.rtr && msg.dlc > 0) {
        Serial.print("Raw Bytes: ");
        for (int i = 0; i < msg.dlc; i++) {
            Serial.printf("0x%02X ", msg.data[i]);
        }
        Serial.println();
        
        Serial.print("ASCII: ");
        for (int i = 0; i < msg.dlc; i++) {
            if (msg.data[i] >= 32 && msg.data[i] <= 126) {
                Serial.print((char)msg.data[i]);
            } else {
                Serial.print(".");
            }
        }
        Serial.println();
    }
    
    Serial.println("---------------------");
}

// Neue Methoden für Integration-Tests

bool CANReader::available() {
    // Alias für hasMessage
    return hasMessage();
}

void CANReader::update() {
    // Holt einen anstehenden Frame ab. readMessage() aktualisiert lastMessage
    // selbst; der Zeitstempel stammt aus dem Empfangszeitpunkt und wird hier
    // bewusst nicht überschrieben.
    if (hasMessage()) {
        readMessage();
    }
}

CANMessage CANReader::getLastMessage() {
    // Gibt die zuletzt empfangene Nachricht zurück
    return lastMessage;
}
