ikoerber/roadtest/(commit log)

2025-07-30 Initial commit: ESP32-S3 Road Quality Measurement System v1.1
    Integriertes Straßenqualitäts-Messsystem mit umfassendem Hardware-Test:
    - BNO055 9-DOF Sensor für Bewegungsanalyse und Vibrationsmessung
    - MicroSD Card Logger für CSV-Datenaufzeichnung
    - OLED Display für Live-Status und Sensor-Daten
    - CAN-Bus Reader mit MCP2515 (DEBO CON Modul)
    - Modulare Code-Architektur mit sauberer Fehlerbehandlung
    Features:
    ✅ Hardware-Tests beim Start mit detaillierter Diagnose
    ✅ OLED Status-Anzeige (Hardware-Check + Live-Daten)
    ✅ Robuste ESP32-S3 Pin-Konfiguration (GPIO 1-13)
    ✅ Erweiterte BNO055Manager Integration
    ✅ Automatische CAN-Bus Kristall-Erkennung (8/16MHz)
    ✅ Vibrations-Analyse und S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
    [MCP2515.cpp, MCP2515.h, bno055_manager.cpp, bno055_manager.h, can_reader.cpp, can_reader.h, main.cpp]
2025-07-30 Update .gitignore to exclude arduino-CAN embedded repository
2025-08-06 Complete system implementation with comprehensive improvements
    Major enhancements:
    • Implemented full OLED display system with test suite
    • Added GPS manager with BN-880 support and diagnostics
    • Enhanced buffer overflow protection with SafeStringFormatter
    • Created centralized hardware configuration system
    • Added comprehensive buffer utilities and memory management
    • Cleaned up legacy code and removed unused headers
    Buffer Security:
    • Multi-layer buffer overflow protection in SD logging
    • Safe string formatting with bounds checking
    • Template-based SafeRingBuffer and SafeMemoryPool
    • Automatic buffer flushing and overflow detection
    Hardware Integration:
    • Complete O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
2025-08-06 Add comprehensive project documentation
    Documentation suite includes:
    • Complete README.md with full project overview and user guide
    • Updated CLAUDE.md with implementation status and development docs
    • New HARDWARE.md with detailed hardware setup and wiring guide
    Key documentation features:
    • Step-by-step installation and setup instructions
    • Complete component list with pricing (~70-80€)
    • Detailed pin-by-pin wiring diagrams for all modules
    • Comprehensive troubleshooting guide for common issues
    • Professional API documentation with code examples
    • Hardware testing procedures and validation checklists
    Technical specifications:
    • Buffer security architecture with mul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
2025-08-06 Fix compilation errors and clean up warnings
    Fixes applied:
    • Remove conflicting ACCEL_BUFFER_SIZE #define to resolve macro/variable conflict
    • Replace missing printBufferStats() call with inline buffer statistics code
    • Remove duplicate BNO055_ADDRESS_* definitions (already in Adafruit library)
    Build status:
    • Compilation: SUCCESS (clean build, no warnings)
    • RAM Usage: 8.8% (28,992 / 327,680 bytes)
    • Flash Usage: 36.0% (471,850 / 1,310,720 bytes)
    • Libraries: All dependencies resolved correctly
    Technical improvements:
    • Eliminates macro expansion conflicts in hardware_config.h
    • Provides inline buffer statistics without external dependency
    • Clean compilation with zer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
    [hardware_config.h, main.cpp]
2026-07-27 Firmware 1.5.10 mit robustem IMUPLUS-Betrieb
2026-07-27 Signalreserve und Diagnose fuer Akkubetrieb verbessern
    Drei Einstellungen waren wirkungslos oder nicht verwendet:
    - Der SSD1306-Treiber setzt den I2C-Takt bei jedem Transfer selbst und
    laesst ihn danach auf seinem Default stehen. Da der erste Bildaufbau vor
    bnoManager.begin() laeuft, hat der BNO055 nie mit dem in setup()
    gesetzten Takt gearbeitet. Beide Taktwerte gehen jetzt explizit an den
    Displaykonstruktor.
    - SD.begin() ohne Frequenzargument nimmt 4 MHz; SD_SPI_SPEED wurde
    nirgends verwendet. Jetzt 1 MHz, explizit uebergeben.
    - Die BNO055-Adresse war an zwei Stellen fest verdrahtet und widersprach
    HARDWARE.md. Sie wird jetzt ueber beide dokumentierten Adressen erkannt.
    Weite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
2026-07-28 CAN-Quarzfrequenz fest eintragen statt zur Laufzeit raten
    Der verbaute Joy-IT SBC-CAN01 traegt einen Quarz mit Aufdruck 16.000.
    CANReader::begin() probierte bisher 16 MHz und schaltete bei Misserfolg
    auf 8 MHz um. Das ist unsicher: begin() erkennt eine falsche Annahme
    nicht, sondern ergibt eine um Faktor zwei falsche Bitrate. Der Knoten
    quittiert dann jeden Frame als Fehler, geht in Bus-Off und haelt die
    INT-Leitung dauerhaft aktiv.
    - CANReader merkt sich die Quarzfrequenz und wendet sie in begin() an.
    setClockFrequency() wurde zuvor von begin() wieder ueberschrieben,
    wodurch die Vorgabe aus main.cpp wirkungslos blieb.
    - main.cpp setzte 8E6 und lag damit falsch; jetzt CAN_CLOCK_16MHZ.
    -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
2026-07-28 CAN-Empfangspfad reparieren und ISR-Falle entschaerfen
    Drei Fehler, die beim Aktivieren von ENABLE_OPTIONAL_CAN sofort zugeschlagen
    haetten.
    1. Jeder Frame ging verloren. hasMessage() und readMessage() riefen beide
    parsePacket() auf. Der Aufruf liest den Frame aus dem Empfangspuffer des
    MCP2515 und quittiert dabei RXnIF; der zweite Aufruf fand nichts mehr vor
    und lieferte eine leere Nachricht. CANReader puffert den geparsten Frame
    jetzt in pendingMessage, fetchPacket() holt hoechstens einen Frame, und
    hasMessage() sowie readMessage() greifen auf denselben Puffer zu.
    In main.cpp entfaellt damit die Pruefung auf canId != 0. Sie war ohnehin
    falsch: 0x000 ist eine gueltige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
2026-07-28 Abschlusswiderstand des CAN-Moduls dokumentieren, Messplan ablegen
    Der Jumper P1 auf dem SBC-CAN01 steckt auf ON, der 120-Ohm-Abschluss ist
    also aktiv. Fuer einen Laboraufbau mit zweitem Knoten ist das richtig, am
    Fahrzeug muss der Jumper ab:
    - Der Fahrzeugbus ist bereits beidseitig mit je 120 Ohm abgeschlossen,
    zusammen 60 Ohm. Ein dritter Widerstand parallel ergibt rund 40 Ohm; der
    Transceiver erreicht die geforderte Differenzspannung fuer den dominanten
    Pegel dann unter Umstaenden nicht mehr.
    - ROADTEST haengt als Stichleitung am OBD-Stecker und ist kein Busende.
    Stichleitungen werden grundsaetzlich nicht abgeschlossen.
    Die Inbetriebnahme-Checkliste bekommt zwei Punkte: VCC und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
2026-07-28 BNO055-Adresse richtigstellen: ADR liegt auf 3,3 V, Adresse ist 0x29
    Der ADR-Pad des Adafruit-Breakouts ist in diesem Aufbau auf 3,3 V gelegt.
    Die Adresse ist damit 0x29, nicht die Adafruit-Standardadresse 0x28.
    HARDWARE.md nannte an drei Stellen 0x28 und lag falsch; der bisherige
    Code mit fest verdrahteter 0x29 lag richtig. Korrigiert sind die
    Pin-Tabelle, die Adressliste, die Inbetriebnahme-Checkliste und der
    Fehlersuche-Abschnitt.
    Damit entfaellt die Vermutung, die Kalibrierprobleme koennten daher
    ruehren, dass die Firmware den Sensor nie erreicht hat. Als Ursachen
    bleiben die urspruenglich benannten: Welligkeit der 3,3-V-Schiene, die
    Neustartkaskade der Hardware-Ueberwachung, der vom S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
2026-07-28 diag gibt einen Controller-Steckbrief aus
    Das Controllerboard ist verloetet und traegt keine auswertbare
    Typbezeichnung. Fuer die Wahl des Ziels in platformio.ini ist der
    Boardname aber gar nicht noetig: Es zaehlen Chip, Flash und PSRAM, und die
    meldet der Controller selbst.
    diag gibt jetzt Chipmodell, Revision, Kernzahl, Taktfrequenz, Flashgroesse
    und -takt, PSRAM-Groesse, die eFuse-MAC sowie Sketchgroesse und freien
    Platz in der Partition aus. Zusaetzlich wird gemeldet, ob der Build
    BOARD_HAS_PSRAM setzt. Findet der Chip keinen PSRAM, obwohl der Build ihn
    erwartet, weist die Ausgabe ausdruecklich auf das unpassende Board-Ziel
    hin - ein Kandidat fuer den bisher unerklaerten Teil des langsa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
2026-07-28 Symptom 4 geklaert: VCC des CAN-Moduls lag auf 5 V
    Die Messung an VCC und VCC1 hat den vermuteten Mechanismus bestaetigt.
    VCC lag auf 5 V statt 3,3 V, damit liefen MCP2515 und die MCP2562-Logik
    mit 5 V. Der SO-Ausgang trieb 5-V-Pegel auf GPIO 11; der Strom floss ueber
    die ESD-Schutzdiode des ESP32-S3 in die 3,3-V-Schiene und hob die
    Versorgung des gesamten Systems an. Genau das bringt beim Aktivieren des
    CAN-Moduls andere Komponenten zum Aufhaengen.
    Die Beschaltung ist korrigiert: VCC auf 3,3 V, VCC1 auf 5 V.
    Als Folge vermerkt: GPIO 11 hat ueber laengere Zeit Klemmstrom gefuehrt,
    oberhalb der zulaessigen rund 20 mA. Ob der Eingang Schaden genommen hat,
    zeigt sich daran, ob die SPI-Kommuni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
2026-07-28 I2C-Pull-ups gemessen: 2,54 kOhm, kein Handlungsbedarf
    An SDA und SCL liegen 2,54 kOhm gegen 3,3 V. Der Wert liegt im
    empfohlenen Fenster von 2,2 bis 4,7 kOhm; im gezogenen Zustand fliessen
    rund 1,3 mA, deutlich unter den 3 mA der Spezifikation.
    Damit scheiden schwache Pull-ups als Ursache der BNO055-Probleme aus. Fuer
    den Basistakt von 100 kHz bleibt die Flankenzeit bis etwa 180 pF
    Busskapazitaet innerhalb der zulaessigen 1000 ns.
    Vermerkt ist ausserdem, wo die Reserve tatsaechlich knapp wird: Die
    400 kHz der SSD1306-Bildtransfers verlangen 300 ns und damit unter etwa
    54 pF. Auf Lochraster ist das eng. Das Display arbeitet einwandfrei;
    falls dort je Artefakte auftreten, ist I2C_DISPLAY_SP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
2026-07-28 Messkampagne fuer den Saleae Logic 8 festhalten
    Drei Kampagnen mit Kanalbelegung, Analyzer-Einstellungen und
    Auswertungskriterien:
    1. Analogkanal auf der 3,3-V-Schiene zusammen mit dem SD-SPI digital. Das
    beantwortet Messpunkt 2 und liefert zusaetzlich den Nachweis, ob ein
    Spannungseinbruch zeitlich mit einer fehlschlagenden SPI-Transaktion
    zusammenfaellt - das leistet weder Multimeter noch Oszilloskop allein.
    2. I2C auf SDA und SCL. Prueft die BNO055-Antworten auf 0x29 und zeigt die
    Flankenform bei den 400-kHz-Displaybursts.
    3. CAN-SPI nach dem Aktivieren von ENABLE_OPTIONAL_CAN, zugleich
    Funktionsprobe fuer GPIO 11 nach der frueheren 5-V-Belastung.
    Vermerkt sind ausserdem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
2026-07-28 Serieller Port als Platzhalter, Watchdog-Fehlermeldung unterdruecken
    Der feste Port /dev/cu.usbmodem101 in platformio.ini schlaegt fehl, sobald
    das Board an einer anderen Buchse oder ueber einen anderen Hub haengt -
    macOS vergibt der nativen USB-CDC-Schnittstelle dann eine andere Nummer,
    aktuell usbmodem2101. upload_port und monitor_port verwenden jetzt den
    Platzhalter /dev/cu.usbmodem*, der alle Varianten trifft und die
    Bluetooth- und Debug-Ports ausschliesst.
    Ausserdem stand im Bootlog:
    E (1010) task_wdt: esp_task_wdt_init(515): TWDT already initialized
    Der Arduino-Kern initialisiert den Task-Watchdog bereits selbst; der
    zweite Aufruf wird von esp_task_wdt_reconfigure() sauber abgefan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
2026-07-28 BNO055-Recovery abstufen statt sofort neu zu starten
    Am Geraet zeigt sich eine Dauerschleife: Nach jedem Neustart meldet der
    Sensor Modus 0x08, System 5, Fehler 0 und Selbsttest 0x0F, faellt aber
    binnen 5 bis 15 Sekunden auf Modus 0x00, System 0 oder 1, Fehler 5
    zurueck. Die Ueberwachung startet ihn daraufhin komplett neu, wodurch die
    gerade erreichte Gyro-Kalibrierung (G3) wieder auf G0 faellt. Der Sensor
    ist so nie messbereit.
    Zwei Ursachen in der Recovery selbst:
    1. Ein fehlgeschlagener I2C-Lesevorgang liefert 0x00 zurueck. "Modus=0x00"
    war damit nicht von einem echten CONFIG-Modus zu unterscheiden.
    verifyFusionMode() pingt die Adresse jetzt zuerst und meldet einen
    ausbleibende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
2026-07-28 I2C-Displaytakt auf 100 kHz absenken
    Ueber 70 s aufgezeichneter Log zeigt: Der BNO055 resettet sich etwa alle
    20 bis 30 Sekunden. Die Abfolge "keine Antwort auf 0x29" gefolgt von
    Modus 0x00 mit Systemstatus 1 ist der Zustand unmittelbar nach einem
    Power-on-Reset; einmal trat sie mit Fehler 0 auf, also voellig sauber.
    Der zuvor ergaenzte Pull-up an RST hat daran nichts geaendert. Ein Reset
    ueber den Pin scheidet damit als Ursache aus.
    Die gemessenen 2,54 kOhm Pull-up erlauben bei 400 kHz nur rund 54 pF
    Buskapazitaet. Auf Lochraster mit zwei Modulen und 10 bis 15 cm Draht
    liegt die reale Kapazitaet darueber, die Flanken sind also zu langsam.
    Verstuemmelte Bits auf SDA koennen ein Adressbyte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
    [hardware_config.h]
2026-07-28 I2C-Aufnahme: BNO055 startet sich selbst neu, Bus ist in Ordnung
    60-s-Aufnahme mit dem Logic 8 auf SDA und SCL. Das OLED quittiert alle 183
    Transaktionen fehlerfrei, unerwartete Adressen treten nicht auf. Der Bus
    ist damit elektrisch unauffaellig.
    Die 94 NACKs an 0x29 liegen in genau zwei Clustern mit identischer
    Signatur: je 47 NACKs ueber 0,46 s, danach 0,55 s Stille. Rund 1 s
    Totalausfall etwa alle 18 s, deterministisch wiederholt. Das entspricht
    der Bootzeit des BNO055 nach einem Power-on-Reset.
    Damit sind zwei eigene Hypothesen widerlegt: Bitfehler durch die
    400-kHz-Displaytransfers (keine Fremdadressen, OLED fehlerfrei) und ein
    floatender RST-Pin (Pull-up gesetzt, Ausfaelle bleiben).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
2026-07-28 BNO055 testweise auf NDOF statt IMUPLUS
    Ingos Beobachtung: Mit Magnetometer, also im NDOF-Modus, lief der Sensor
    frueher ueber laengere Zeit stabil. Das passt zum Fehlerbild - der Sensor
    meldet wiederholt SYS_ERR 9, "Fusion algorithm configuration error", also
    einen Fehler der Fusionskonfiguration selbst.
    Die Logic-8-Aufnahme hat den I2C-Bus als Ursache ausgeschlossen: Das OLED
    quittiert im selben Zeitraum alle 183 Transaktionen fehlerfrei, unerwartete
    Adressen treten nicht auf. Der BNO055 faellt trotzdem rund alle 18 s fuer
    etwa eine Sekunde komplett vom Bus. Damit bleibt der Modus als Kandidat.
    ROADTEST_BNO_MODE steht deshalb auf OPERATION_MODE_NDOF. Rueckstellen durch
    Eintragen von OPER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
    [bno055_manager.h]
2026-07-28 Modusabhaengige Stellen fuer NDOF nachziehen
    Die Umstellung auf NDOF war unvollstaendig. Nachgezogen:
    Funktional relevant:
    - REQUIRED_SELF_TESTS stand fest auf 0x0D und schloss das Magnetometer
    (Bit 0x02) aus. In NDOF gehoert es zur Fusion; ein defektes Magnetometer
    waere stillschweigend durchgegangen. Jetzt 0x0F in NDOF, 0x0D sonst.
    - isFullyCalibrated() verlangt in NDOF zusaetzlich mag == 3, sonst gibt
    getSensorOffsets() die Werte nicht heraus.
    - getCalibrationInstructions() nennt in NDOF die liegende Acht.
    - showCalibrationStatus() bekommt den mag-Wert und zeigt ihn an. Ohne das
    waere beim Kalibrieren am Geraet nicht sichtbar, wann es fertig ist.
    - Die Webseite zeigt den Magneto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
2026-07-28 Rueckschritt nach RST-Loeteingriff festhalten
    Seit dem Einloeten des 10-kOhm-Pull-ups faellt auch das OLED zeitweise
    aus. In der Logic-Aufnahme davor hatte es ueber 183 Transaktionen null
    NACKs. Damit sind beide I2C-Teilnehmer betroffen, was auf Bus oder
    Versorgung deutet statt auf den Sensor allein.
    Naechste Schritte notiert: 3,3-V-Schiene unter Spannung und spannungsfrei
    messen, Widerstandswert und Einbauort des Pull-ups pruefen, und ihn
    wieder ausloeten, um den Ausgangszustand als Vergleichsbasis
    herzustellen.
    Der NDOF-Modus hat die Ausfaelle nicht behoben: Modus 0x0C wird korrekt
    gesetzt, Selbsttest 0x0F, aber "keine Antwort auf 0x29" und SYS_ERR 9
    treten weiter auf.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
2026-07-28 BNO055 und SD-Logging stabilisieren
2026-07-28 Fahrzeugdatenerkennung und Diagnose erweitern
2026-07-28 GPS- und OBD-Datenqualitätsplan festlegen
2026-07-29 GPS-/OBD-Datenqualität und Recovery stabilisieren
2026-07-30 Firmware 1.5.27: Kurven- und SD-Recovery stabilisieren
2026-07-31 Auswertelogik hardwarefrei auslagern und Hosttests einführen
    Kurvenerkennung und Fahrbahnbewertung lagen bisher in BNO055Manager und waren
    nur durch Ausfahrten prüfbar. Beide sind jetzt eigene Einheiten ohne Arduino-,
    Sensor- und Zeitabhängigkeiten:
    - src/curve_detector.{h,cpp}: Kurvenerkennung
    - src/road_metrics.{h,cpp}: Vibrationsanalyse, Straßenqualität, Schlaglöcher
    BNO055Manager bildet nur noch die Sensorwerte auf die Eingangsstrukturen ab.
    Zeitangaben verwenden uint32_t statt unsigned long, damit Host und Ziel
    dasselbe Überlaufverhalten zeigen.
    Neue PlatformIO-Umgebung native mit 37 Hosttests, Laufzeit unter zwei
    Sekunden, ohne Firmware-Flash zu belegen. Das ist wesentlich,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
    [bno055_manager.cpp, bno055_manager.h, curve_detector.cpp, curve_detector.h, hardware_config.h, road_metrics.cpp, road_metrics.h]
2026-07-31 Doku auf den Stand von 1.5.28 nachziehen
    Die Auslagerung der Auswertelogik war nur in CLAUDE.md und CHANGELOG.md
    vermerkt. Nachgetragen:
    - Architekturliste in CLAUDE.md und AGENTS.md um src/curve_detector.{h,cpp}
    und src/road_metrics.{h,cpp} ergänzt. src/road_quality.h ist dort nicht mehr
    als "Fahrbahn- und Kurvenmetriken" beschrieben, sondern als das, was die
    Datei tatsächlich enthält: die Datenstruktur RoadMetrics.
    - AGENTS.md war ein Spiegel von CLAUDE.md und um den gesamten
    Hosttest-Abschnitt sowie `pio test -e native` in Befehlstabelle und
    Commit-Checkliste zurückgefallen. Beide Dokumente sind wieder deckungsgleich.
    - Buildwerte in beiden Dokumenten auf den gemessenen Sta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
2026-07-31 Kartenauswertung der Messdaten als GeoJSON ergaenzen
    Der Datenqualitätsplan sieht ein Auswertungswerkzeug unter tools/ vor; das
    Verzeichnis existierte bisher nicht. tools/export_geojson.py wandelt eine
    Messsitzung in GeoJSON zum Hineinziehen in geojson.io.
    Ebenen:
    - Strecke, eingefärbt nach Straßenqualität oder wahlweise nach der Abweichung
    zwischen GPS- und OBD-Geschwindigkeit (--modus)
    - Schlaglöcher als Marker, Farbe und Größe nach Schwere
    - Kurven als tatsächlich gefahrener Bogen, sofern die Sitzung Anfangs- und
    Endzeit liefert (ab Schema 1.5.28), sonst als Punkt
    - Referenzintervalle des Beifahrer-Kurventests
    - Sitzungskopf mit Firmware, Kennzahlen und Laufzeitdiagnose
    Dami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
2026-07-31 Beifahrer-Kurventest auf eine Bildschirmseite umstellen
    Alle Bedienknöpfe sind jetzt gleichzeitig sichtbar, ohne zu scrollen. Der
    Seitenrahmen ist 100dvh hoch, die Knopffläche nimmt den verbleibenden Platz
    ein und die Knöpfe wachsen mit. Damit passt die Seite auf jedes Gerät, ohne
    feste Größen zu raten; im Querformat bleiben rund 79 Pixel je Knopfreihe.
    Die sechs Referenzarten stehen in fester 2x3-Anordnung, linke Spalte für
    Linkskurven, rechte für Rechtskurven. Erledigte Arten verschwinden nicht mehr,
    sondern werden deaktiviert dargestellt. Bisher verschoben sich dadurch während
    der Fahrt die Positionen der übrigen Knöpfe, was für eine Bedienung nach
    Position ungünstig ist.
    J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
2026-07-31 Kurvenintervalle schaerfen und beim Messende abschliessen
    Ausgewertet wurden die fuenf Beifahrer-Referenzfahrten vom 31.07.2026 mit
    zusammen 55 von Hand markierten Referenzkurven.
    Das Ruhefenster der Kurvenerkennung bewertet jetzt die Netto-Kursaenderung
    im Fenster statt einzelner Stichproben. CURVE_LONG_MIN_RATE_DPS von
    0,8 Grad/s liegt unter dem Rauschband der Gierrate unter Fahrt; auf
    nachgewiesen gerader Strecke wurden bis zu 1,5 Grad/s gemessen. Jede
    Rauschspitze in Kurvenrichtung setzte das Fenster zurueck, sodass Ereignisse
    ueber mehrere Kurven hinweg zusammenliefen. Im Wiedergabestand steigt der
    Anteil der Ereignisdauer, der von echten Drehstichproben belegt ist, von
    67 auf 90 Proze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
2026-08-01 Mindestfahrweg und Mindest-Querbeschleunigung fuer Kurvenereignisse
    Ein Kurvenereignis benoetigt jetzt zusaetzlich 10 Meter Fahrweg und
    0,4 m/s² mittlere Querbeschleunigung.
    Die Geschwindigkeitsfreigabe allein reichte nicht: GPS-Drift im Stand wird
    mit bis zu 8 km/h als gueltig ausgewiesen. In 20260731_160627_085A6E1C
    entstanden daraus zwei Kurven mit 2,5 und 3,4 Meter Radius ueber 1,6 und
    1,8 Meter Fahrweg, waehrend das Geraet in der Hand gedreht wurde. Der
    Streckenzaehler filtert dasselbe Rauschen seit jeher ueber eine
    Mindestsegmentlaenge.
    Massgeblich fuer die zweite Regel ist die Querbeschleunigung, nicht der
    Radius. Ein Bogen mit 500 Meter Radius bei 90 km/h wurde von der
    Beifahrerse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
    [curve_detector.cpp, hardware_config.h]
2026-08-01 Wiedergabe auf die Geschwindigkeitswahl der Firmware umstellen
    Der Pruefstand fuetterte die Kurvenerkennung mit der GPS-Geschwindigkeit,
    die Firmware bevorzugt aber OBD. In allen Fahrten des 31.07.2026 lag die
    OBD-Geschwindigkeit durchgehend im 500-ms-Takt vor; die Wiedergabe hat also
    durchweg ein anderes Eingangssignal ausgewertet als das Geraet.
    test_wiedergabe_referenzfahrten waehlt die Geschwindigkeit jetzt wie
    main.cpp: zuerst OBD, sonst GPS, sonst unbekannt. Damit gibt die Wiedergabe
    die Firmwarelaeufe ereignisgenau wieder - 174 zu 174 Ereignissen bei 0,1 Grad
    mittlerer Winkelabweichung und 7 bis 21 Millisekunden Startversatz in den
    Fahrten mit belastbarer Zeitbasis. Allein mit der GP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
2026-08-01 Zeitbasis des Wiedergabevergleichs robuster bestimmen
    Ohne Beifahrer-Referenzmarker leitete das Werkzeug den Versatz zwischen
    Geraete- und Sitzungszeit aus dem ersten Kurvenereignis ab. Dessen
    Schreibzeitpunkt liegt aber hinter dem Ereignisende, und zwar je nach
    Abschlussgrund unterschiedlich weit: nach QUIET vergeht das volle
    Ruhefenster von zwei Sekunden, nach REVERSAL fast nichts. Der geschaetzte
    Versatz war dadurch bis zu zwei Sekunden falsch, was die Zuordnung kurzer
    Ereignisse zerlegte.
    Jetzt wird das Maximum ueber alle Ereignisse genommen, das dem kleinsten
    Schreibverzug entspricht. Auf den vier Fahrten vom 01.08.2026 fiel der
    gemessene Startversatz damit von rund 2000 auf 144 bis 60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
2026-08-01 Abnahme von 1.5.29 am Fahrzeug festhalten
    Vier Fahrten am 01.08.2026 ueber zusammen 21 Minuten und 9,1 Kilometer, ohne
    Beifahrer-Referenzmarker. Alle vier Sitzungen vollstaendig, kein SD-Abbruch.
    Die Zeitabdeckung der Ereignisse liegt bei 97 Prozent im Median gegenueber
    67 Prozent mit 1.5.28; nur 1 von 66 Ereignissen bleibt unter 60 Prozent, mit
    1.5.28 waren es 37 Prozent aller Ereignisse. Kein Ereignis lief mehr in die
    Hoechstdauer, mit 1.5.28 gab es zwei Ausreisser ueber volle 60 Sekunden. Kein
    Kurvenereignis entstand im Stand.
    Der Abgleich der Wiedergabe gegen die Firmwareereignisse ordnete 65 von 66
    Ereignissen zu; drei der vier Fahrten stimmen ereignisgenau bei 0,0 bis
    0,1 Grad Winkel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
2026-08-01 SD-Flush aufteilen und Zusammenfassung nach Abbruch nachtragen
    Der Flush sicherte bisher alle neun Dateien in einem Zug und blockierte die
    Hauptschleife dabei gemessen bis zu 235 Millisekunden. Die verfehlten
    Sensorstichproben lagen deterministisch bei 2290 und 2590 Millisekunden
    modulo 5000, also genau im Takt dieses Durchlaufs; das kostete rund 19 von
    653 Stichproben je Minute und drueckte die effektive Rate auf 9,6 Hz.
    Neu sichert flushStep() je Aufruf hoechstens eine Datei oder die Statuszeile.
    Zehn Schritte im Abstand von 500 Millisekunden ergeben einen vollen Umlauf in
    fuenf Sekunden, also dieselbe Sicherungsfrequenz wie zuvor. Der Aufruf steht
    in der Hauptschleife bewusst hinter der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
2026-08-01 Kurvenboegen im GeoJSON-Export tatsaechlich zeichnen
    StartUptimeMs und EndUptimeMs eines Kurvenereignisses zaehlen seit dem
    Geraetestart, die GPS-Spur dagegen seit dem Sitzungsbeginn. Der Export
    verglich beide Zeitbasen unmittelbar miteinander; sie liegen um die gesamte
    bisherige Geraetelaufzeit auseinander, im geprueften Fall um 252.824 ms. Kein
    einziger GPS-Punkt fiel dadurch je in ein Kurvenintervall, und saemtliche
    Kurven landeten im Punkt-Rueckfall - mit dem irrefuehrenden Hinweis, die
    Sitzung habe keine Anfangs- und Endzeit.
    Der Versatz wird jetzt bestimmt und angewandt: bevorzugt aus einem
    Referenzmarker der Beifahrerseite, der ohne Verzoegerung geschrieben wird,
    sonst aus dem Maximu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
2026-08-01 Logdateien am Sitzungsende gegen die Karte pruefen
    In 20260801_114252_B9D1628B verbuchte die Firmware 3534 erfolgreiche
    GPS-Schreibvorgaenge, die Datei enthielt aber nur 1122 Zeilen und endete nach
    227 von 709 Sekunden. 68 Prozent der GPS-Spur fehlen. Alle acht uebrigen
    Dateien der Sitzung decken die volle Dauer ab, saemtliche Fehlerzaehler
    standen auf null, und SDWrites von 18.125 entspricht der Annahme, dass alle
    3534 Zeilen geschrieben wurden - gegenueber 15.734 bei nur den vorhandenen
    1122. Der Verlust liegt damit unterhalb der Firmware; ihre eigene
    Buchfuehrung war in sich schluessig, und stats.totalWrites zaehlt
    ausschliesslich im Erfolgszweig.
    Ein erfolgreich gemeldeter Schreibvorgan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
2026-08-01 Gegentest mit zweiter SD-Karte als zurueckgestellt vermerken
    Mangels Ersatzkarte laesst sich nicht pruefen, ob der stille Datenverlust an
    der Karte oder am System liegt. Der Vermerk haelt fest, dass vorher keine
    weitere Ursachensuche in der Firmware lohnt: Deren Buchfuehrung war in diesem
    Fall nachweislich in sich schluessig.
2026-08-01 Unvollstaendige GPS-Spur im Sitzungskopf ausweisen
    Bricht die Linie in geojson.io vorzeitig ab, war bisher nicht erkennbar, ob
    die Auswertung fehlerhaft ist oder Daten fehlen. Der Sitzungskopf vergleicht
    die Zeilenzahl der GPS-Datei jetzt mit dem Zaehler GPSSnapshots der Firmware
    und traegt bei Abweichung gpsZeilenErwartet, gpsZeilenFehlend und einen
    erklaerenden Hinweis ein.
    In 20260801_114252_B9D1628B sind das 2412 fehlende von 3534 gezaehlten
    Zeilen; die Strecke endet nach 227 von 709 Sekunden. Vollstaendige Sitzungen
    bleiben unveraendert ohne Zusatzfelder.
2026-08-01 OLED-Treiber entfernen, Display als I2C-Diagnosemittel behalten
    Das Display wird nicht mehr genutzt, die Hardware bleibt verbaut. Entfallen
    sind src/oled_manager.{h,cpp} mit 674 Zeilen, 64 Aufrufstellen in main.cpp,
    die OLED-Schritte der Integrationstests, die Displayzeile der Statusseite,
    der serielle Displaytest und die beiden Adafruit-Bibliotheken.
    Damit entfiel auch die Bootstatus-Anzeige samt Zustandsverwaltung
    (updateBootStatusDisplay, bootStatusActive, BOOT_READY_HOLD_TIME): Sie hat
    nach dem Ausbau nur noch Variablen gesetzt, die niemand mehr liest. Die
    Pruefung requiredHardwareReady() bleibt und erscheint jetzt im seriellen diag
    als "Pflichthardware bereit"; sonst waere mit dem Disp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
2026-08-01 Beifahrer-Kurventest ausbauen
    Die gefuehrte Seite /curve-test entfaellt samt ihren sechs Routen, dem
    Seitenaufbau, der Zustandsverwaltung und dem Status-JSON. Ihr Zweck ist
    erfuellt: Am 31.07.2026 entstanden damit fuenf Referenzfahrten mit zusammen
    55 markierten Kurven. Diese Daten liegen in testdata/ und sind als Festwerte
    in test_wiedergabe_referenzfahrten verankert; sie bleiben die Messgrundlage
    fuer Schwellwertaenderungen der Kurvenerkennung. Der Prueffall selbst
    funktioniert also unveraendert weiter, nur die Aufnahmeseite ist weg.
    Mit ihr entfaellt der Parameter flushImmediately von SDLogger::logEvent(). Er
    existierte allein fuer die gepufferten Referenzmarker, damit ein Knopfdruck
    wae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
2026-08-01 Befunde aus dem Code-Review der Aenderungen 1.5.29 bis 1.5.33
    Die Groessenpruefung aus 1.5.31 verlor ihre Grundlinie. Die Rueckstellung der
    Byte-Zaehler stand im gemeinsamen Rumpf von processLoggingStart() hinter
    FINALIZE und lief damit erst, nachdem openLogFile() die Ausgangswerte
    einschliesslich Kopfzeile gesetzt hatte. Die erwartete Groesse fiel je Datei
    um die Kopfzeile zu niedrig aus; ein Verlust in genau dieser Groessenordnung
    waere unentdeckt geblieben. Die Rueckstellung steht jetzt in PREPARE, also vor
    dem Oeffnen.
    Ein dauerhaft fehlendes OLED erzeugte seit 1.5.32 endlos Meldungen. Die
    Verzweigung haengt an oledDetectedAtLeastOnce, das nie zurueckfaellt; zuvor
    schaltete oledManager.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
2026-08-02 Ueberholten Datenqualitaetsbericht zu 1.5.25 entfernen
    testdata/DATENQUALITAET_2026-07-30_1.5.25.md faellt weg. Der Inhalt bleibt
    ueber die Versionsgeschichte erreichbar (d8adc1a).
    Der QS-Bericht zu 1.5.28 fuehrte die Datei in seinem Pruefkopf als
    Vorbericht auf. Der Verweis waere ins Leere gelaufen und entfaellt; der
    zweite Vorbericht bleibt unveraendert stehen.
2026-08-02 Fahrten vom 02.08.2026 auswerten: SESSION_END und Reproduzierbarkeit belegt
    Drei Fahrten mit 1.5.34: eine Strecke hin und zurueck sowie zwei Kreise auf
    dem Parkplatz. Alle Sitzungen vollstaendig, kein SD-Abbruch, keine
    Integritaetsdatei, Wiedergabe gegen die Firmwareereignisse 33 zu 33 bei
    0,1 Grad.
    SESSION_END ist dreimal belegt und damit der letzte offene Punkt aus 1.5.29
    erledigt: 356,9 Grad bei 18,7 km/h, 327,2 Grad bei 23,0 km/h und 34,1 Grad
    bei 36,4 km/h. Die Werte sind in sich stimmig; 57,9 Meter Bogenlaenge auf
    356,9 Grad ergeben 9,3 Meter Radius, und v²/r trifft die protokollierte
    Querbeschleunigung genau.
    Die Hauptfahrt lief hin und zurueck ueber dieselbe Strecke und liefert da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
2026-08-02 Hosttests finden ihre Messdaten auch im Archiv
    Am 02.08.2026 wanderten sieben Sitzungen nach testdata/archiv/. Die vier
    Wiedergabetests suchten weiter unter testdata/<Sitzung>/, fanden nichts und
    meldeten TEST_IGNORE. Die Suite blieb dabei gruen: "45 succeeded, 4 skipped".
    Abgeschaltet war damit ausgerechnet der Pruefstand, der laut CLAUDE.md die
    Messgrundlage jeder Schwellwertaenderung an der Kurvenerkennung ist.
    findFixture() sucht einen Pfad unterhalb von testdata/ jetzt zusaetzlich
    unter testdata/archiv/. Der Lauf meldet wieder 49 von 49; die
    festgeschriebenen Kennzahlen halten unveraendert. Eine Gegenprobe mit
    entnommener Sitzung faellt korrekt auf 2 skipped zurueck, der Suchpfad wird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
2026-08-02 GPS-Aussetzer vom 02.08.2026 als sporadisch einordnen
    Der Empfang kehrte noch am selben Tag ohne Eingriff zurueck, 11 Satelliten.
    Der Ausfall ist damit sporadisch und nicht dauerhaft.
    Die Firmware scheidet als Ursache aus. Sie sendet dem BN-880 nichts - kein
    Serial2.write, kein UBX, kein PMTK -, sondern oeffnet den UART und liest.
    gps_manager.cpp ist seit dem 30.07.2026 unveraendert und damit aelter als die
    Fahrten vom 01.08.2026 mit 12 Satelliten bei HDOP 0,68. Die OLED-Commits
    beruehrten GPS nur in geloeschten Anzeigezeilen; I2C liegt auf GPIO 8/9, GPS
    auf GPIO 15/16. Unabhaengig davon blieb die Fix-LED dunkel, und die haengt am
    Modul, nicht am ESP32.
    Ein Kaltstart scheidet ebenfalls aus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
2026-08-02 AGENTS.md auf den Stand von CLAUDE.md bringen
    AGENTS.md stand auf 1.5.28, sechs Versionen zurueck. Sie nannte den in 1.5.32
    ausgebauten OLED-Treiber src/oled_manager.{h,cpp} als Architekturbestandteil,
    verlangte die in 1.5.33 entfernte Beifahrerseite /curve-test als naechsten
    Testschritt und fuehrte Buildzahlen von 95,5 statt 93,0 Prozent Flash. Ein
    Werkzeug, das sie liest, arbeitete nach diesen Regeln.
    Eigene Inhalte hatte sie keine: Jede Zeile, die nur in AGENTS.md stand, war
    eine ueberholte Fassung einer Zeile aus CLAUDE.md. Sie ist deshalb jetzt
    wortgleich.
    Damit das nicht wieder auseinanderlaeuft, steht die gemeinsame Pflege als
    Entwicklungsregel in beiden Dateien, mit diff AGENTS.md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
2026-08-02 Fahrbahnbewertung auf die echte Vertikale stellen und Fahrbarkeit bewerten
    Die Bewertung lief ueber die rohe Sensorachse accelZ. Im Fahrzeug liegt die
    Vertikale dort nicht: In 20260802_095708_84FD688D verteilt sich die
    Schwerkraft auf (8,60 / -4,23 / -1,85) m/s2, accelZ traegt also 19 Prozent der
    Vertikalen, und die Korrelation zur tatsaechlichen Vertikalen betraegt -0,06.
    Damit ging Quer- und Laengsbeschleunigung als Fahrbahnstoss durch. Die
    Qualitaetszahl lag in Kurven im Median bei 72,6 und ausserhalb bei 92,1, die
    Stichproben ueber der Stossschwelle waren mit 838 gegen 127 um das 6,6-fache
    ueberhoeht, und drei von fuenf Schlagloechern lagen innerhalb eines
    Kurvenereignisses. Fuer den Zw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
2026-08-02 Beifahrerseite zur Fahrbahnbewertung
    Die Fahrbarkeit ist ein Urteil, keine physikalische Groesse. Ob 1,42 m/s2 noch
    zuegiges Fahren zulassen, kann keine Messung beantworten - die beiden
    Notengrenzen aus 1.5.35 stammen bisher aus dem beobachteten Wertebereich einer
    einzigen Fahrt und sind damit Konvention, nicht Messung.
    Die neue Seite /fahrbahn liefert die fehlenden Wertepaare: vier
    Wertungsstufen von sehr gut bis schlecht sowie ein Knopf fuer den
    Belagswechsel. Die Marker heissen FAHRBAHN_URTEIL mit der Stufe in Schwere und
    FAHRBAHN_BELAGSWECHSEL.
    Das unterscheidet den Fall von der in 1.5.33 entfernten Seite /curve-test:
    Deren Referenzmarker bestaetigten nur, was ohnehin objektiv vorlag,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
2026-08-02 Beifahrerurteil an seinen Abschnitt binden
    Die Aufzeichnung hing schon bisher nicht an der Bewertung: /fahrbahn ruft
    ausschliesslich logEvent(), Start und Ende bleiben allein bei /ride/start und
    /ride/stop. Aussetzen war also jederzeit moeglich.
    Folgenlos war es aber nur auf dem Geraet, nicht in der Auswertung. Gilt ein
    Urteil bis zum naechsten Marker, zieht eine Pause von zehn Minuten die letzte
    Wertung ueber zehn Minuten unbewertete Strasse - und niemand sieht der Datei
    an, dass dort gar nicht bewertet wurde.
    Jedes Urteil traegt jetzt die laufende Abschnittsnummer und den Weg im offenen
    Abschnitt mit; dasselbe gilt fuer den Belagswechsel. Ein Urteil bezieht sich
    dadurch auf genau seinen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
2026-08-02 Fahrbarkeitsnote gegen Beifahrerurteile kalibrieren
    Die beiden Notengrenzen aus 1.5.35 stammten aus dem beobachteten Wertebereich
    einer einzigen Fahrt und waren damit Konvention. 135 Beifahrerurteile auf 119
    Abschnitten einer 52-Kilometer-Fahrt machen daraus eine Messung.
    Effektivwerte je Wertungsstufe im Median: sehr gut 0,663, gut 0,843, maessig
    1,373, schlecht 1,316 m/s2. Die beste Trennung zwischen "geht noch" und "geht
    nicht mehr" liegt bei 1,08 m/s2 und ordnet 100 von 119 Abschnitten richtig zu,
    also 84 Prozent - fuer eine subjektive Zielgroesse ein belastbarer Wert.
    GOOD steht deshalb auf 0,55 statt 0,5 und BAD auf 1,60 statt 3,0; die Note 50
    liegt damit genau auf der Trennschwelle.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
2026-08-02 Fahrbarkeit und Beifahrerurteile im Kartenexport
    export_geojson.py kennt die Ereignisse ABSCHNITT, FAHRBAHN_URTEIL und
    FAHRBAHN_BELAGSWECHSEL. Abschnitte erscheinen als breite eingefaerbte Linie
    entlang der tatsaechlich gefahrenen Spur, Urteile und Belagswechsel als
    Marker. Die Urteilsfarben sind bewusst andere Farbtoene als die der gemessenen
    Fahrbarkeit, damit unterscheidbar bleibt, was gemessen und was geurteilt
    wurde. Urteile werden als Einzelpunkte gezeichnet und nie verbunden: Ein
    Urteil gilt fuer seinen Abschnitt, nicht bis zum naechsten Marker.
    Die Note wird dabei aus dem Effektivwert neu berechnet statt aus der Logdatei
    uebernommen. Der Effektivwert ist die Messung, die Note die Au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
2026-08-02 Kartenexport auf einzelne Ebenen beschraenken
    Eine 52-Kilometer-Fahrt ergibt vollstaendig rund 2500 Merkmale und 1,8 MB;
    geojson.io wird damit traege. Wer nur eine Frage beantworten will, blendet den
    Rest jetzt aus.
    --ebenen waehlt aus strecke, referenz, fahrbarkeit, kurve, schlagloch,
    beifahrerurteil, belagswechsel und sitzung. --nur-fahrbarkeit ist die Kurzform
    fuer die Fahrbarkeitsansicht samt Urteilen und Sitzungskopf und ergibt 395
    Merkmale bei 574 kB; nur deren Linien sind 259 Merkmale und 529 kB. Den
    groessten Anteil traegt die Streckenebene mit einem Merkmal je GPS-Segment.
    Der Dateiname nennt die Auswahl, damit mehrere Ansichten derselben Sitzung
    nebeneinander bestehen. Die freie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
2026-08-02 Farbklassen der Fahrbarkeit nach den Beifahrerstufen benennen
    Die erste Fassung nannte alles unter Note 25 "nicht mehr zuegig fahrbar". Von
    den 42 betroffenen Abschnitten trugen 27 ein Urteil, davon 20 die Stufe
    "maessig" und nur 2 die Stufe "schlecht". Die Messung traf also zu, ihre
    Benennung war uebertrieben.
    Die Klassen tragen jetzt die Namen der Beifahrerstufen und liegen in der Mitte
    zwischen deren Notenmedianen: ueber 81 "sehr gut", ueber 47 "gut", darunter
    "maessig bis schlecht". Stufe 3 und 4 bleiben zusammengefasst, weil sie ueber
    den Effektivwert nicht trennbar sind. Ueber die 52-Kilometer-Fahrt ergibt sich
    26 Prozent "sehr gut", 43 Prozent "gut" und 31 Prozent "maessig bis
    schlec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
2026-08-02 Belegen, dass die Anzeige das Beifahrerurteil nicht geankert hat
    Die Beifahrerseite zeigt den zuletzt abgeschlossenen Abschnitt mit Note und
    Effektivwert. Spraeche ein Urteil die angezeigte Zahl nach, waere die
    Kalibrierung zirkulaer.
    Die angezeigte Note des Vorabschnitts erreicht eine Rangkorrelation von -0,57
    zur Wertungsstufe, der Effektivwert des eigenen Abschnitts dagegen +0,73 -
    und der war zum Zeitpunkt des Urteils noch gar nicht berechnet. Waere das
    Urteil von der Anzeige gezogen, muesste der sichtbare Wert besser vorhersagen
    als der unsichtbare. Er sagt schlechter vorher.
    Der Beifahrer haelt zudem fest, dass die angezeigten Werte das eigene
    Empfinden gut wiedergaben.
    Co-Authored-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
2026-08-02 Hohe Geschwindigkeit als Beleg fuer eine tragfaehige Fahrbahn
    Wer schnell faehrt, traut der Strasse. Weil die Anregung mit der
    Geschwindigkeit steigt, stufte der Effektivwert allein schnell gefahrene
    Abschnitte zu schlecht ein: Zwei Abschnitte der Fahrt 20260802_113909_C8F1C2F3
    erhielten die Note 0 bei 130 km/h im Durchschnitt.
    Ab ROAD_DRIVEABILITY_FAST_KMH von 100 km/h faellt die Note deshalb nicht unter
    ROAD_DRIVEABILITY_FAST_MIN_NOTE von 47, die Klassengrenze zwischen "gut" und
    "maessig". Ueber die 52-Kilometer-Fahrt betrifft das 8 von 259 Abschnitten;
    der Anteil "maessig bis schlecht" sinkt von 31 auf 27 Prozent.
    Die Regel wirkt bewusst nur in einer Richtung. Hohe Geschwindigkeit beleg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
2026-08-02 Recherche: Zugang zu den Fahrdynamikdaten des 991
    Der verbaute Sport Chrono ist keine Datenquelle. Er speichert im 991.1 nichts
    Exportierbares und besitzt keine Schnittstelle; die App-gestuetzte
    Aufzeichnung kam erst mit dem 991.2. Er ist selbst nur Mithoerer der
    Fahrwerkssensorik.
    Diese Sensorik liegt am Gateway-Stecker an, und AiM Technologies dokumentiert
    den Zugang fuer genau dieses Fahrzeug: Fahrerseite unter der Lenksaeule ueber
    dem Sicherungskasten, Pin A20 orange/rot verdrillt als CAN High, Pin A10
    orange/braun verdrillt als CAN Low. Verfuegbar waeren Lenkwinkel und
    Lenkgeschwindigkeit, vier einzelne Raddrehzahlen, vier Bremsdruecke,
    Querbeschleunigung, Gang und der gewaehlte Fahrmo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
2026-08-02 Toten CAN-Logpfad entfernen und SD-Hardwaretest ehrlich machen
    Zwei Befunde aus dem Review zur Hardwareaustauschbarkeit.
    CANReader::enableLogging() wurde nirgends aufgerufen. Damit stand
    loggingEnabled dauerhaft auf false, und logMessage() wie flushLog() kehrten
    bei jedem Aufruf sofort zurueck - auch die drei Aufrufstellen in
    integration_tests.cpp und main.cpp liefen ins Leere. Dieselbe Rolle spielte
    die globale canLoggingEnabled in main.cpp, die ebenfalls nie true wurde. Die
    CAN-Aufzeichnung laeuft vollstaendig ueber SDLogger::logCANMessage().
    Der tote Pfad war der einzige Grund, warum can_reader.h die SD-Bibliothek
    einband und ein File-Member hielt. Entfernt sind 76 Zeilen in can_reader.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
2026-08-03 Kompressionsstrom als eigenstaendige Einheit
    Vorarbeit fuer komprimierte Logdateien. Die Einheit kapselt ausschliesslich
    Deflate und gzip-Rahmung; sie kennt weder Sitzungen noch Logtypen und ruehrt
    den funktionierenden Rekorder nicht an. Die Verdrahtung in sd_logger folgt
    getrennt, damit der am Fahrzeug bestaetigte Schreibpfad nicht in einem Zug mit
    einer ungeprueften Kompression umgebaut wird.
    Der Kompressor stammt aus dem ROM des ESP32-S3. miniz ist dort vollstaendig
    vorhanden, die Symbole stellt esp32s3.rom.ld bereit, der Header liegt unter
    esp_rom/include/miniz.h. Der Zuwachs betraegt dadurch 160 Byte Flash statt der
    befuerchteten 15 bis 25 Kilobyte - die Sorge um das knappe Flashbudget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
2026-08-03 Notenskala auf Kopfsteinpflaster bestaetigen
    Zwei Fahrten am 03.08.2026 ueber 29,4 Kilometer mit 34 Urteilen und erstmals
    zehn Belagswechselmarkern. Beide Sitzungen vollstaendig, SDErrors und
    SDDropped null, keine Integritaetsdatei.
    Die Grenzen bleiben unveraendert. Mit 149 statt 119 Urteilen liegt die
    Trennung zwischen "geht noch" und "geht nicht mehr" weiterhin bei 1,08 m/s2
    und trifft 85 statt 84 Prozent. ROAD_DRIVEABILITY_RMS_GOOD_MPS2 von 0,55 und
    _BAD_MPS2 von 1,60 sind damit gegen zwei unabhaengige Fahrtage belegt.
    Die am 02.08.2026 dokumentierte Grenze bei Stufe 4 war kein Methodenproblem,
    sondern fehlende Daten. Dort stand, Stufe 4 habe keinen hoeheren Effektivwert
    als Stufe 3, we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
2026-08-03 Review-Befunde beheben: Kopierpfad, Detektor-Reset und Benennung
    Vier Punkte aus dem Code-Review vom 03.08.2026:
    - copyFile() prueft jetzt jedes Lese- und Schreibergebnis und entfernt
    bei einem Abbruch die unvollstaendige Zieldatei, statt eine scheinbar
    gueltige Kopie als Erfolg zu melden.
    - GzipStream dokumentiert die Lebensdauer der uebergebenen File-Instanz
    (adressstabil bis end()) und die ueber end() hinaus lesbare
    Fehlersemantik von healthy().
    - CurveDetector::reset() raeumt auch lastCurveEvent. reset() liefert
    damit den versprochenen frischen Detektor; die Wiedergabetests
    bestaetigen 66 von 66 mit unveraenderten Kennzahlen.
    - detectPothole() nennt seinen Parameter vertical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
    [bno055_manager.cpp, bno055_manager.h, curve_detector.cpp, gzip_stream.h, road_metrics.cpp, road_metrics.h, sd_logger.cpp]
2026-08-03 1.5.37: Sentinel 0xFF der Temperatur-PIDs nicht als Messwert verbuchen
    Die PIDs 0x46 und 0x5C rechnen A - 40 ueber ein einzelnes Byte. 0xFF
    bedeutet dort "Wert derzeit nicht verfuegbar" und ergab umgerechnet
    215 °C, was die Firmware bis 1.5.36 als gueltige Messung mit
    AmbientValid=1 protokollierte.
    Beleg: 28 von rund 530 Antworten auf 0x46 in den Discovery-Sitzungen vom
    29./30.07.2026 trugen genau dieses Byte; in 20260729_170946_05A4DB46
    sind das 45 von 2438 gueltigen Zeilen bei echten Werten zwischen 31 und
    34 °C. Im Rohframe: 03 41 46 49 sind 33 °C, 03 41 46 FF waren die 215.
    Die Antwort zaehlt weiterhin als Antwort - decoded bleibt true, damit
    ECU-Erreichbarkeit, Antwortzaehler und T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
2026-08-03 Testberichte der Juli-Sitzungen nach testdata/archiv/ verschieben
    Die fuenf Berichte folgen ihren Messsitzungen, die am 02.08.2026 ins
    Archiv gewandert sind. Inhaltlich unveraendert; git erkennt reine
    Umbenennungen.
    Die zehn Verweise in README, CLAUDE.md, AGENTS.md, dem
    Datenqualitaetsplan und dem QS-Bericht ziehen mit, sonst zeigten sie
    nach dieser Verschiebung ins Leere. Geprueft: Jeder testdata-Verweis in
    der Dokumentation loest auf eine vorhandene Datei auf.
    Die Rohmessungen des Archivs bleiben wie bisher aus dem Repository
    heraus - von 294 Dateien sind nur diese fuenf Berichte versioniert.
2026-08-03 1.5.38: Teuersten Flush-Schritt teilen und zuordenbar machen
    Schritt 1 erledigte als einziger zwei teure Operationen - den
    Puffer-Write der Sensordatei und deren Dateiflush - und war damit der
    einzige Schritt oberhalb der 100-ms-Slotbreite.
    Messgrundlage 20260803_082231_D0606CF2: ueber 3.180 Schritte lag der
    Mittelwert bei 19,1 ms, das Maximum bei 111 ms, ein einzelner SD-Vorgang
    darin bei 79 ms. Bei 319 Umlaeufen standen 396 verfehlte Sensorslots,
    also gut einer je Umlauf. Ueber die Sitzungen vom 02. und 03.08.2026 sind
    das 13 bis 16 verfehlte Slots je Minute oder 2,2 bis 2,7 Prozent.
    Der Puffer-Write bleibt Schritt 1, der Dateiflush wird Schritt 2.
    SD_FLUSH_STEP_COUNT steigt auf 11, das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
2026-08-03 1.5.39: Irrefuehrende Meldungen beheben, OLED entfernen
    Vier Meldungen behaupteten etwas, das nicht stimmte - alle vier sind am
    03.08.2026 bei der SD-Fehlersuche aufgefallen und haben dort Zeit
    gekostet.
    "SD-Karte nicht gefunden": SD.begin() erledigt Karteninitialisierung und
    Mount in einem Aufruf und trennt die Faelle nicht. Eine Karte antwortete
    auf CMD0 nachweislich mit 0x01, war also elektrisch da, scheiterte aber
    an der Initialisierung - und die Firmware meldete, es stecke keine
    Karte. Die Meldung nennt jetzt alle drei Ursachen und verweist auf
    'hardware', das ueber die CMD0-Rohantwort trennt.
    Buffer-Test: safePrintf() liefert die Zahl geschriebener Zeichen und -1
    bei drohender Trunca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
2026-08-03 1.5.40: Hardware-Test gibt die SD-Karte wieder frei
    testSDWithSafePins() greift roh auf den SPI-Bus zu und schaltet MOSI und
    SCK zwischenzeitlich auf INPUT_PULLUP. Hielt der SDLogger die Karte
    parallel eingebunden, zog ihm das den Bus unter den Fuessen weg: CMD0
    meldete danach 0xFF, die automatische Wiedererkennung kam bis zum
    naechsten Neustart nicht mehr durch, und der Test riet zum Pruefen des
    MISO-Kabels - waehrend die Karte einwandfrei war und nach einem Neustart
    sofort wieder lief. Der Test diagnostizierte also einen Fehler, den er
    selbst verursacht hatte.
    Die Karte wird jetzt vor dem Test ausdruecklich freigegeben und danach
    wieder eingebunden, mit sichtbarer Rueckmeldung. Eine laufe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
2026-08-04 QS-Bericht zu 1.5.28 entfernen
    Der Bericht beschrieb den Prüfstand der Kurvenerkennung zum Stand 1.5.28.
    Diese Rolle trägt inzwischen test_wiedergabe_referenzfahrten: Die
    Referenzintervalle der fünf Beifahrerfahrten vom 31.07.2026 sind dort als
    Festwerte hinterlegt und laufen bei jedem pio test -e native mit. Ein
    Dokument daneben veraltet unbemerkt, der Test nicht.
    Die Messdaten der Fahrten selbst bleiben unberührt.
2026-08-04 SD-Datenverlust als unerklaerten Einzelfall abschliessen
    Der Verlust aus 20260801_114252_B9D1628B hat sich seit dem 01.08.2026 nicht
    wiederholt: zwoelf Sitzungen mit aktiver Integritaetspruefung aus 1.5.31,
    keine einzige road_integritaet-Datei, ueberall Zeilenzahl gleich Zaehler.
    Der Gegentest mit der seit dem 04.08.2026 eingesetzten neuen Karte wird
    ausdruecklich nicht als Beweis gefuehrt. Ein Fehler, der in rund 30 Sitzungen
    einmal auftrat, ist mit einer Fahrt weder zu bestaetigen noch auszuschliessen;
    "mit neuer Karte sauber" waere ein Ergebnis, wo keines vorliegt.
    An die Stelle eines Ergebnisses tritt ein Verfahren: Die Groessenpruefung aus
    1.5.31 bleibt der stehende Melder. Erst ein z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
2026-08-04 Streckendatenbank als Projektziel festschreiben
    Die Firmware ist Mittel, nicht Zweck. STRECKENDATENBANK.md legt das Ergebnis
    verbindlich fest: aus muehelos aufgezeichneten Fahrten entsteht auf dem
    Rechner eine Bewertung der befahrenen Strassen, aus der sich neue Strecken
    zusammensetzen lassen.
    Festgelegt sind Ergebnis in zwei Stufen (bewertete Karte, danach
    Routengenerator), das richtungsbehaftete Wegstueck zwischen zwei Kreuzungen
    als Einheit, der Bewertungsablauf mit Noten nach der Fahrt samt mitlaufenden
    Ankersegmenten gegen den Notendrift, vier pruefbare Abnahmekriterien und die
    Umsetzungsreihenfolge. Die Notenskala bleibt ausdruecklich offen, und die
    Fahrspass-Formel wird nicht vor den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
2026-08-04 1.5.41: Ballast fuer den Einbau ins Fahrzeug entfernen
    Das Geraet soll einmal eingebaut und nicht mehr angefasst werden. Drei
    Baugruppen sind damit gegenstandslos:
    - Die interaktive Testsuite integration_tests war mit 59,3 kByte das groesste
    Modul der Firmware, groesser als der SD-Logger. Ihre Tests warten teilweise
    auf Eingaben an der Konsole - hinter der Verkleidung sitzt niemand mehr, der
    etwas eingibt. Entfallen: integration, stress, recovery, sdrecovery, quick,
    memory.
    hardware und buffer bleiben. I2C-Scanner, BNO055-Pruefung, SD-Test mit
    sicheren Pins und Puffersicherheit liegen in main.cpp und hingen nie an
    diesem Modul; damit bleibt auch die Korrektur aus 1.5.40 wirks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
2026-08-04 1.5.42: Aufzeichnung startet ohne Handgriff
    Das Geraet haengt nach STRECKENDATENBANK.md an zuendungsgeschalteter
    Spannung. Damit ist die Versorgung selbst das Startsignal: Strom da bedeutet
    fahren, Strom weg bedeutet Fahrtende. Sobald die SD-Karte bereit ist, beginnt
    die Aufzeichnung von allein - keine Bewegungserkennung, keine Zuendungslogik,
    kein Zustandsautomat.
    Der Start laeuft ueber requestLoggingStart() und damit ueber dieselbe nicht
    blockierende Startlogik wie der Webbefehl; pro Schleifenrunde wird hoechstens
    eine Datei geoeffnet, die Webseite bleibt erreichbar. Er erfolgt genau einmal
    je Geraetestart, sonst liesse sich eine laufende Aufzeichnung nicht mehr
    beenden: stop und /ride/st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
2026-08-04 1.5.43: Daten uebers Handy holen
    Die Karte zu ziehen ist bei einer Fahrt pro Woche gleichgueltig und bei
    taeglichen Fahrten der Grund, warum die Streckendatenbank nicht waechst - erst
    recht, wenn das Geraet hinter der Verkleidung sitzt. /files zeigt jetzt die
    Sitzungen auf der Karte und gibt jede als ein .tar.gz aus.
    Eine Sitzung ist ein Tippvorgang. Sie besteht aus zehn Dateien; einzeln geholt
    waeren das bei zweihundert Fahrten zweitausend Bedienschritte. tar xzf liefert
    am Rechner genau die Verzeichnisstruktur, die export_geojson.py und die
    Wiedergabetests erwarten.
    Komprimiert, nicht roh - genau daran scheiterte die frueher entfernte
    Downloadfunktion mit rund 12 MB je Fahrtstunde. Der K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
2026-08-04 1.5.44: Ruecksprung auf die vorherige Firmware
    Ein fehlerhaftes Abbild macht ein eingebautes Geraet zum Ausbauteil. Der
    Bootloader des ESP32-S3 kann das auffangen -
    CONFIG_BOOTLOADER_APP_ROLLBACK_ENABLE ist im Arduino-Unterbau gesetzt -, aber
    der Mechanismus lief ins Leere: initArduino() markiert jedes Abbild als
    gueltig, bevor setup() ueberhaupt laeuft. Damit galt alles als gut, was bis zur
    Arduino-Initialisierung kam, auch eine Firmware, deren WLAN danach nicht mehr
    hochkommt. Genau der Fall, der ein verbautes Geraet unerreichbar macht.
    Ueber den vom Kern vorgesehenen Haken verifyRollbackLater() bleibt das Abbild
    jetzt in PENDING_VERIFY, bis es sich selbst bestaetigt hat. Startet es vorhe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
2026-08-04 Dokumentationsluecken des Einbauumbaus schliessen
    Drei Stellen waren beim Umbau auf das fest eingebaute Geraet stehengeblieben.
    README.md beschrieb die mit 1.5.41 entfernte Fahrzeugdaten-Erkennung weiter
    als aktuelle Funktion, samt discover-Befehlen und Phasenablauf. Der Abschnitt
    ist jetzt ein Rueckblick nach dem Muster des Beifahrer-Kurventests: was die
    Suche tat, was sie erbracht hat - die PIDs 0x0C, 0x0D und 0x11 sind am
    Fahrzeug bestaetigt - und warum sie entfallen ist. Der Historieneintrag zu
    v1.5.14 bleibt unveraendert, er beschreibt korrekt, was jene Version tat.
    HARDWARE.md nannte als Versorgung weiterhin USB-C oder den LiPo-Anschluss,
    einschliesslich Pruefliste. Das ist die zentr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
2026-08-04 1.5.45: Download messen statt vermuten
    Der Download aus 1.5.43 dauert am Geraet sehr lange und bleibt zeitweise
    stehen. Die Gesamtdauer benennt aber keine Ursache: Der Weg besteht aus drei
    Stufen - von der Karte lesen, komprimieren, ueber WLAN senden -, und jede
    koennte es sein.
    /speedtest?kb=1024&bs=1460 misst das WLAN allein: Nutzdaten aus dem
    Arbeitsspeicher, weder Karte noch Kompression, sonst derselbe Weg. Das
    Ergebnis steht am Ende der Antwort, ohne serielle Konsole und ohne Stoppuhr.
    bs waehlt die Blockgroesse je sendContent(); der Vergleich von bs=512 gegen
    bs=4096 beantwortet unmittelbar, ob viele kleine HTTP-Chunks bremsen - der
    Kompressor gibt seine Bloecke in der Groesse aus, di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
2026-08-04 1.5.46: Ausgabe des Downloads puffern
    Die Messung am Geraet hat die Ursache benannt. Zwei /speedtest-Laeufe mit
    gleicher Datenmenge und verschiedener Blockgroesse: 512 Byte ergaben 89,4 kB/s
    in 2048 Bloecken, 1460 Byte ergaben 190,4 kB/s in 718 Bloecken - fast dieselbe
    Zeit je Aufruf bei dreifacher Datenmenge.
    Daraus faellt der Aufwand auseinander: Ein sendContent() kostet rund 4,57 ms
    Fixaufwand unabhaengig vom Inhalt, plus etwa 2 us je Byte. Die Grenzrate liegt
    bei rund 500 kB/s. Das WLAN ist also schnell, und der Aufwand je Aufruf frisst
    es auf.
    Der Kompressor gibt seine Bloecke in der Groesse aus, die ihm passt, und jeder
    davon ging bisher einzeln als HTTP-Chunk hinaus. Die Senke samme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
    [hardware_config.h, web_manager.cpp]
2026-08-04 1.5.47: bench misst den Kompressionsdurchsatz allein
    Der Download durchlaeuft drei Stufen, zwei davon sind gemessen: Das WLAN
    liefert 190 kB/s, der SD-Takt laesst real 60 bis 90 kB/s zu. Beobachtet wurden
    am Geraet aber 40 Byte/s - und zwar mit 1.5.46, also bereits mit der
    Pufferung auf 4 kB. Damit ist die Blockgroesse als Hauptursache widerlegt; sie
    war ein realer, aber kleiner Effekt.
    Zwei Groessenordnungen fehlen, und die einzige Stufe ohne eigene Messung ist
    die Kompression. bench misst sie ohne Karte und ohne Netz: Nutzdaten aus dem
    Arbeitsspeicher im Format der Sensordatei, Ausgabe in eine Senke, die nur
    zaehlt. Uebrig bleibt reine Rechenzeit. Ausgegeben werden zusaetzlich freier
    inte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
2026-08-04 1.5.48: Der Download meldet, was er tut
    Die Aufschluesselung aus 1.5.45 schrieb ausschliesslich am Ende. Jeder
    vorzeitige Ausstieg - 400, 409, 404, 503 - und jedes Haengenbleiben mitten in
    der Uebertragung erzeugte damit gar keine Ausgabe. "Keine Zeile" war so nicht
    von "langsam" zu unterscheiden, und die Ursachensuche lief ins Leere. Das war
    ein Fehler der Instrumentierung, nicht des Geraets.
    Jeder Ausgang meldet sich jetzt einzeln, dazu die Uebertragung im
    Sekundentakt mit gelesener und gesendeter Menge sowie den Zeiten fuer Lesen
    und Senden. Bleibt der Download stehen, zeigt die letzte Zeile die Stelle.
    Dabei ist ein zweiter Fehler aufgefallen: File::name() liefert je nach Version
    der S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
2026-08-06 1.5.49: Der Download sendet geprueft
    Der Download lieferte 4.096 Byte und blieb dann stehen; die zuvor genannten
    "40 Byte/s" waren dieselbe Beobachtung.
    Die Ursache liegt in WebServer::sendContent() - es verwirft den Rueckgabewert
    von write(). Der TCP-Sendepuffer fasst 5.760 Byte
    (CONFIG_LWIP_TCP_SND_BUF_DEFAULT), ein einzelner Kompressorrueckruf liefert
    aber 10 bis 17 kB am Stueck. Das sind zwei bis vier 4-kB-Bloecke unmittelbar
    hintereinander ohne Rueckkehr in die Hauptschleife: Der erste passt hinein,
    der zweite nicht. NetworkClient::write() gibt dann eine Teilmenge zurueck,
    die angekuendigte Chunk-Laenge stimmt nicht mehr, und die Gegenstelle wartet
    endlos auf Bytes, die nie kommen.
    Da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
2026-08-06 Ausgebautes OLED in der Hardwaredoku nachziehen, Schaltplan als KiCad
    Das SSD1306 ist seit dem 03.08.2026 ausgebaut. CLAUDE.md und AGENTS.md waren
    darauf gezogen, HARDWARE.md, schematic.md und README.md nicht: Die
    Baugruppentabelle fuehrte das Display noch als "Verbaut", das Mermaid-Diagramm
    zeigte es am I2C-Bus, und die Inbetriebnahme-Checkliste verlangte einen Test
    darauf.
    Aufgefallen ist das beim Zeichnen des Schaltplans - die Quelle widersprach
    sich selbst.
    Zwei Stellen waren schon vorher falsch:
    - Die Baugruppentabelle in HARDWARE.md widersprach CLAUDE.md direkt.
    - Der Absatz zur Flankenreserve nannte I2C_DISPLAY_SPEED als Stellhebel.
    Dieses Makro existiert nicht mehr; hardware_con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
    [roadtest.kicad_sch]
2026-08-06 1.6.4: Download laeuft, Dateiliste in Sekunden
    Der Download ist am Geraet bestaetigt. Sitzung 20260804_231644_CE01F092,
    3,9 MB roh: 445.125 Byte in 45 s, gzip -t sauber, 11 von 11 Dateien mit
    korrekten Groessen, ausgepackt byteweise intakt, kein Neustart.
    URSACHE: Stapelueberlauf des Loop-Tasks, nicht das Senden.
    Die serielle Konsole nennt ihn eindeutig:
    Guru Meditation Error: Core 1 panic'ed (Unhandled debug exception).
    Debug exception reason: Stack canary watchpoint triggered (loopTask)
    Der Verursacher steckt in miniz. Beim Abschluss eines Deflate-Blocks legt
    tdefl_optimize_huffman_table() zwei Felder tdefl_sym_freq syms0[288] und
    syms1[288] an - zusammen 2.304 Byte auf dem Stapel.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
    [hardware_config.h, main.cpp, web_manager.cpp]
2026-08-06 1.7.0: Aufzeichnung startet erst mit stehender ECU-Verbindung
    Dies kehrt eine Festlegung aus STRECKENDATENBANK.md um. Dort stand: "Der
    Start ist bewusst nicht an CAN gekoppelt. Ein Busfehler kostet dann die
    OBD-Werte, nicht die ganze Fahrt." Die Kopplung ist ausdrücklich gewünscht
    worden; die Spezifikation ist entsprechend nachgezogen und haelt Umkehr,
    Grund und Preis fest.
    Ausschlaggebend war der Bestand auf der Karte: 114 Sitzungen, davon 31 unter
    200 kB. Das sind Leerlaeufe von der Werkbank, die bei jedem Anstecken der
    USB-Versorgung entstehen. Sie kosten kaum Platz - 3 Prozent -, aber sie
    verstopfen die Dateiliste und spaeter die Segmentdatenbank. Zuendungs-
    geschaltete Spannung allei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
